EmbeddedSystemClass/patalla_pedidos_domicilo_TIA/Hardware/000_Documentacion/Imagenes_Multimedia/Ensamble2.jpeg

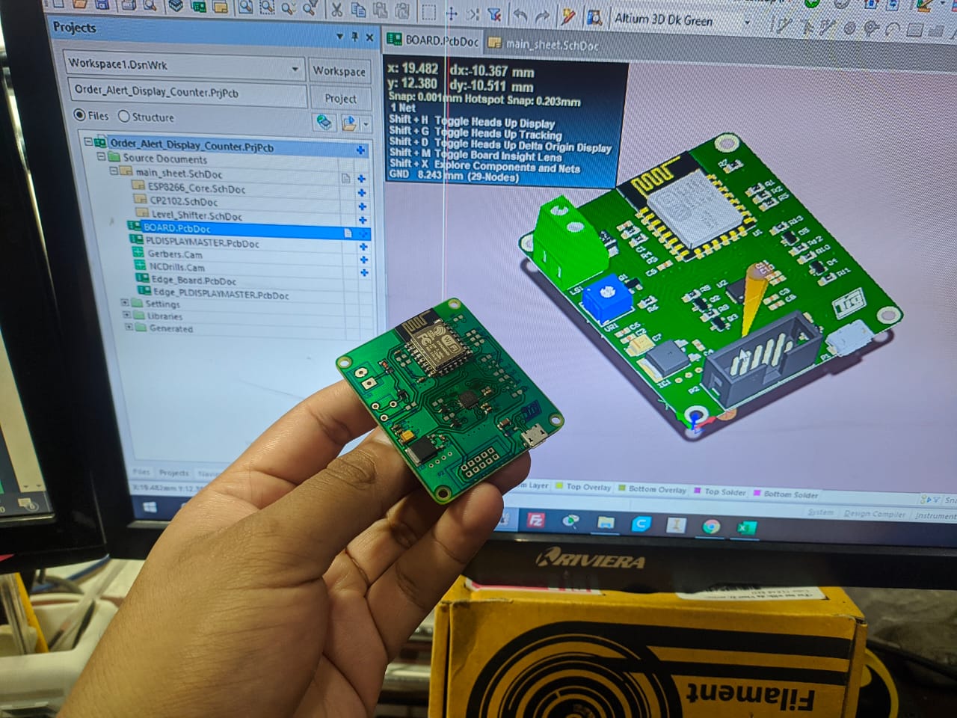
Hardware/000_Documentacion/Imagenes_Multimedia/Ensamble2.jpeg
