EmbeddedSystemClass/patalla_pedidos_domicilo_TIA/README.md

# Alerta_de_Pedidos_Counter
Firmware Arduino de Pantalla de Pedidos, basada en el SOC (Yystem on a chip) ESP8266
