EmbeddedSystemClass/patalla_pedidos_domicilo_TIA/Hardware/000_Documentacion/Imagenes_Multimedia/01_Wifi_Module.png

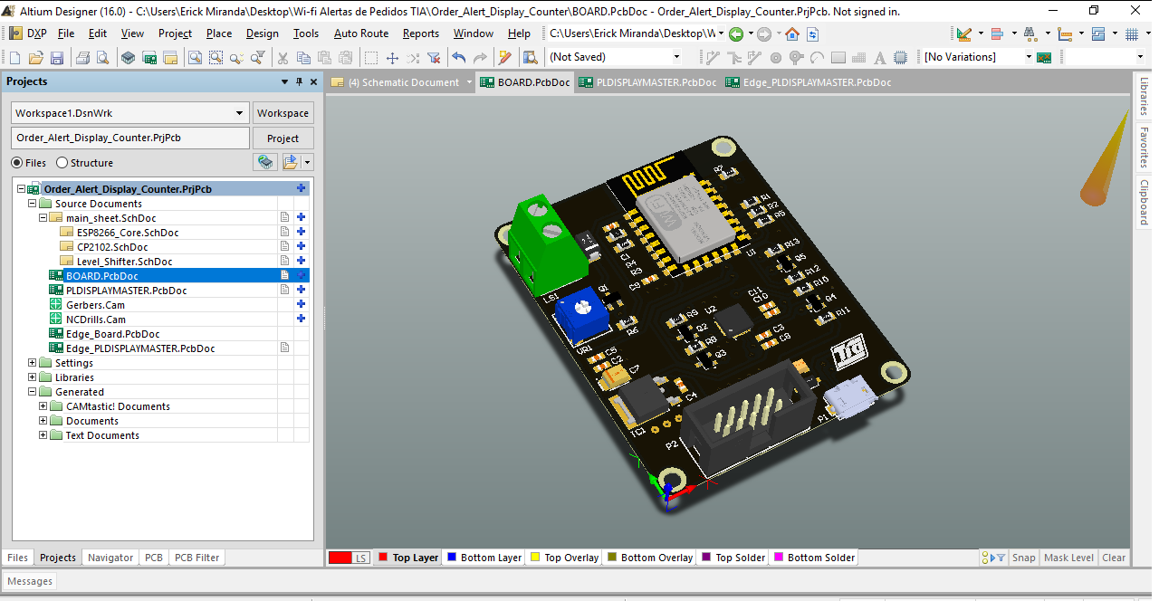
Hardware/000_Documentacion/Imagenes_Multimedia/01_Wifi_Module.png
