EmbeddedSystemClass/patalla_pedidos_domicilo_TIA/Hardware/000_Documentacion/Imagenes_Multimedia/02_DYSPLAY_Module.png

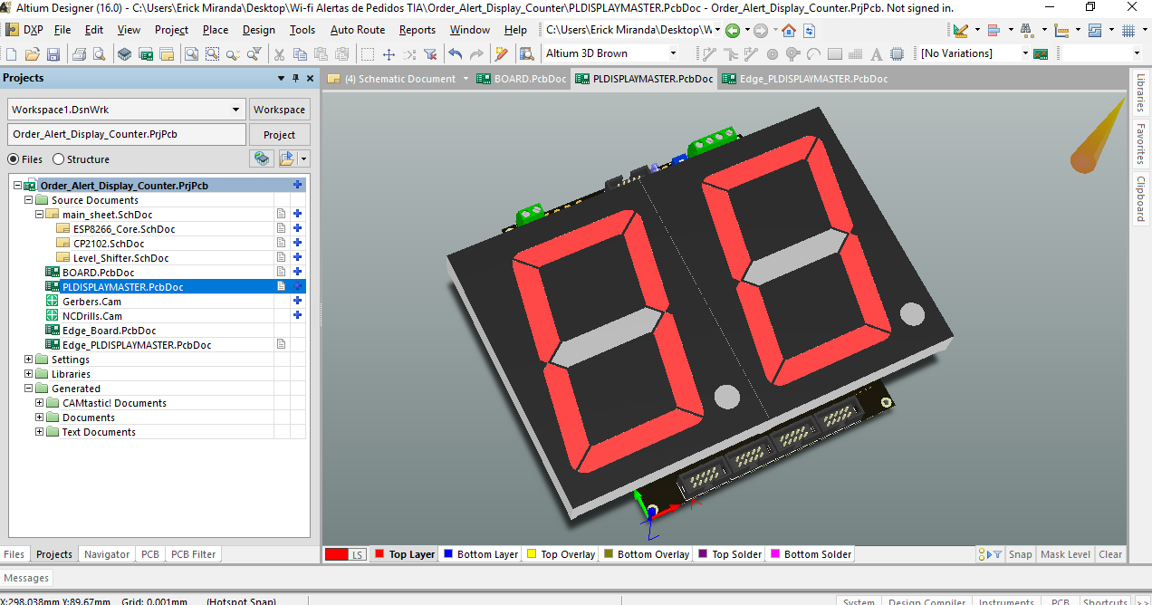
Hardware/000_Documentacion/Imagenes_Multimedia/02_DYSPLAY_Module.png
