EmbeddedSystemClass/patalla_pedidos_domicilo_TIA/Hardware/000_Documentacion/Imagenes_Multimedia/03_Oreder_Alert_Counter_0.png

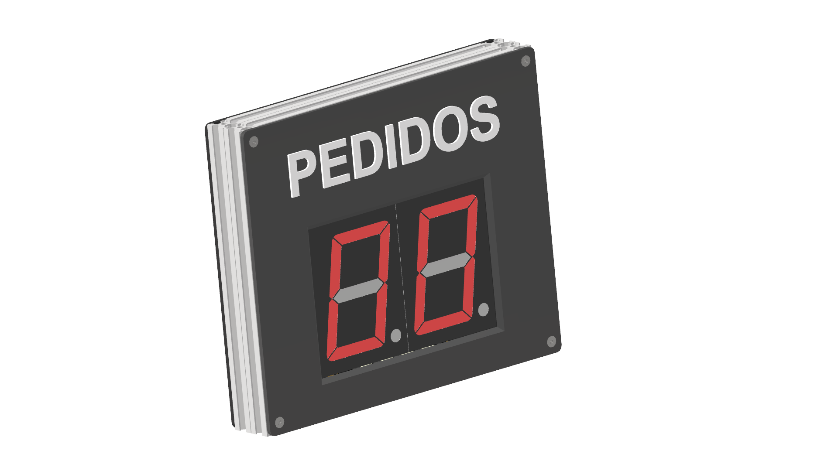
Hardware/000_Documentacion/Imagenes_Multimedia/03_Oreder_Alert_Counter_0.png
