EmbeddedSystemClass/patalla_pedidos_domicilo_TIA/Hardware/000_Documentacion/Imagenes_Multimedia/04_Oreder_Alert_Counter_1.png

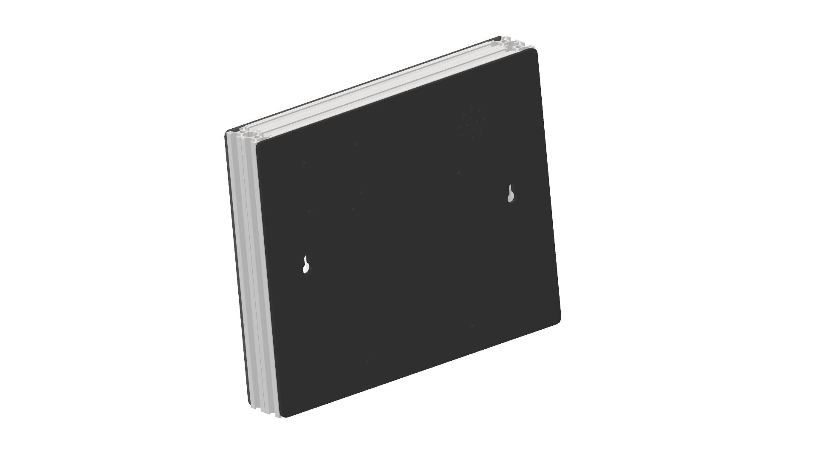
Hardware/000_Documentacion/Imagenes_Multimedia/04_Oreder_Alert_Counter_1.png
