EmbeddedSystemClass/patalla_pedidos_domicilo_TIA/Hardware/000_Documentacion/Imagenes_Multimedia/05_Final Device Price.png

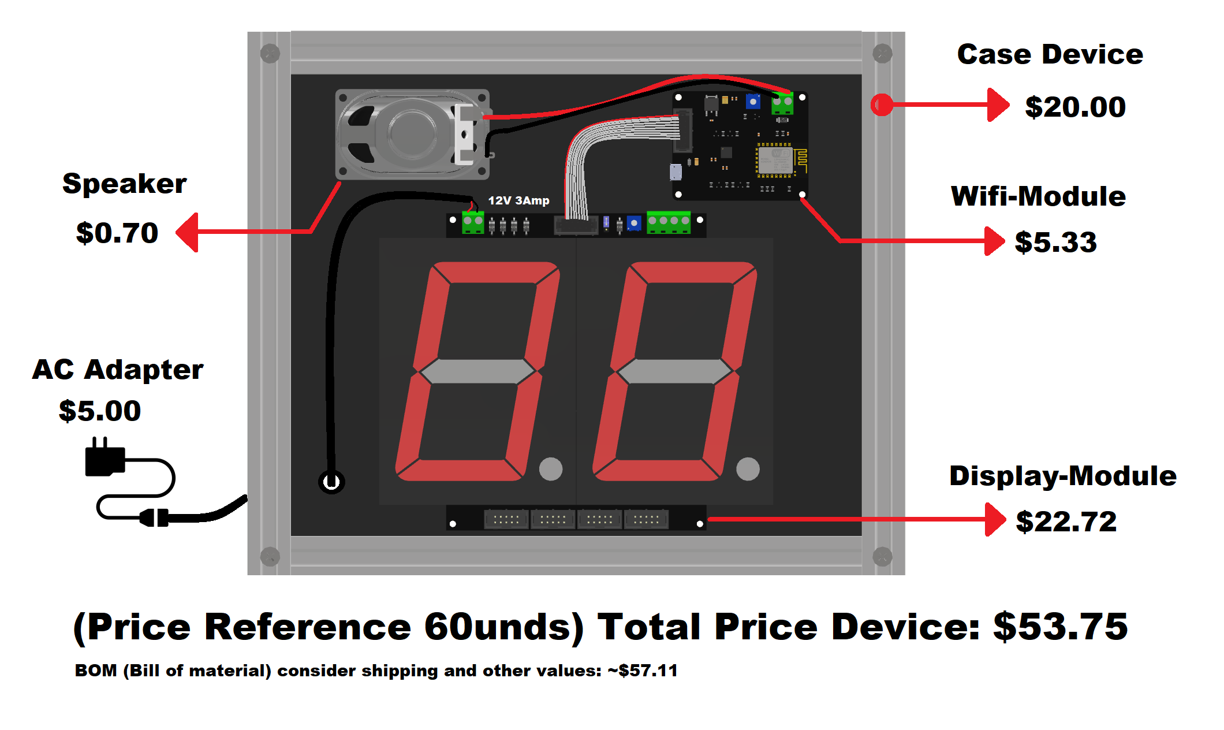
Hardware/000_Documentacion/Imagenes_Multimedia/05_Final Device Price.png
