EmbeddedSystemClass/patalla_pedidos_domicilo_TIA/Hardware/000_Documentacion/Imagenes_Multimedia/Eleccion de Sucursal.jpeg

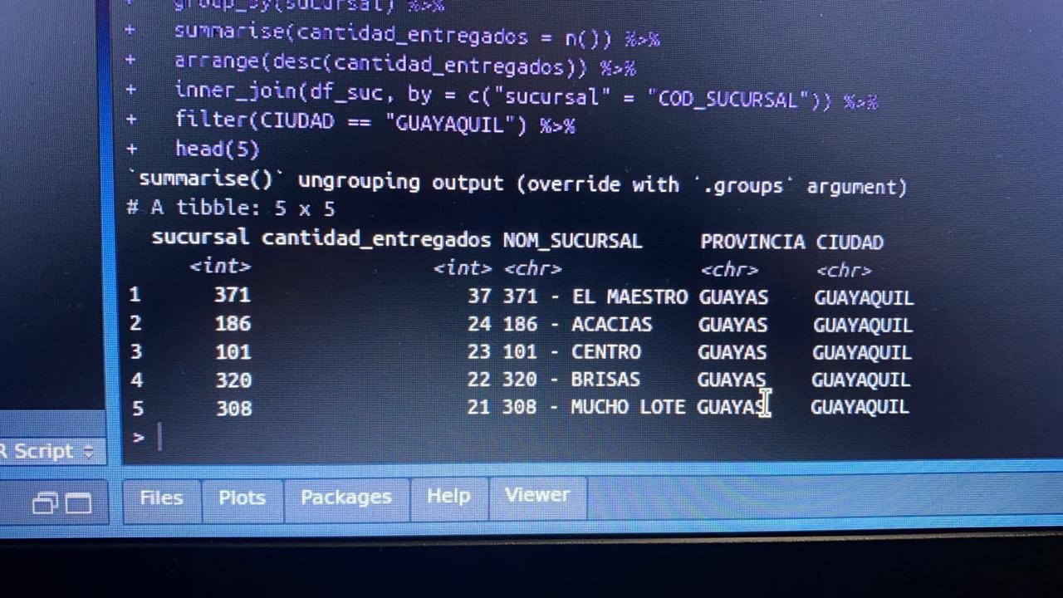
Hardware/000_Documentacion/Imagenes_Multimedia/Eleccion de Sucursal.jpeg
