EmbeddedSystemClass/patalla_pedidos_domicilo_TIA/Hardware/000_Documentacion/Imagenes_Multimedia/Enclosure 2.png

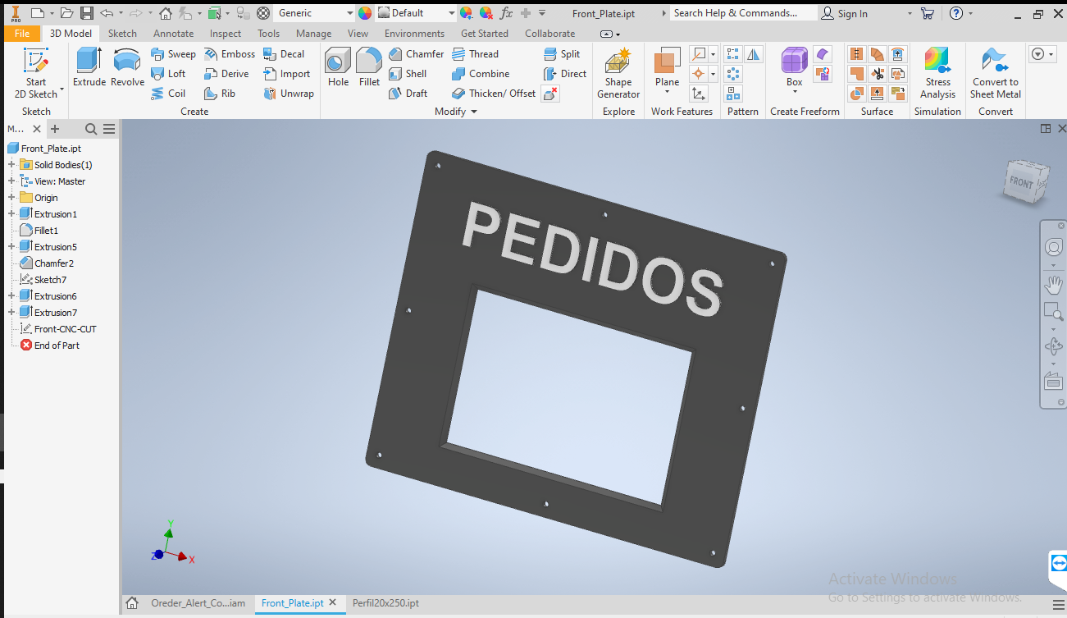
Hardware/000_Documentacion/Imagenes_Multimedia/Enclosure 2.png
