EmbeddedSystemClass/patalla_pedidos_domicilo_TIA/Hardware/000_Documentacion/Imagenes_Multimedia/Factura Adaptador.jpeg

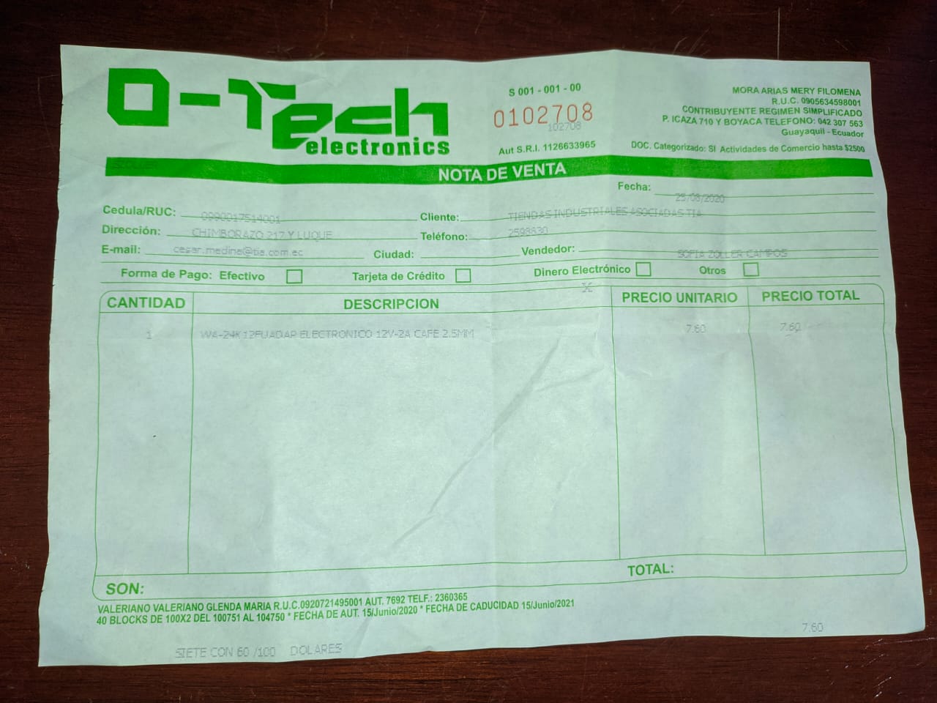
Hardware/000_Documentacion/Imagenes_Multimedia/Factura Adaptador.jpeg
