EmbeddedSystemClass/patalla_pedidos_domicilo_TIA/Hardware/000_Documentacion/Imagenes_Multimedia/Firmware.png

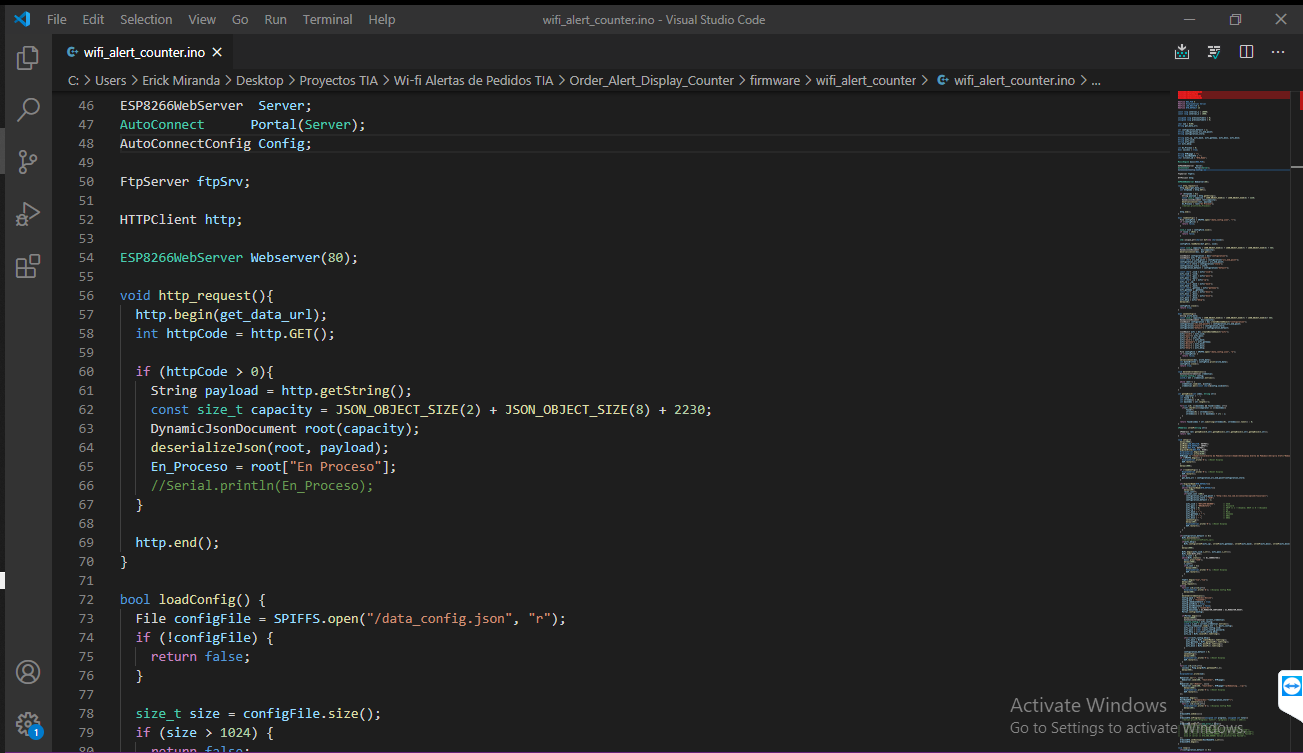
Hardware/000_Documentacion/Imagenes_Multimedia/Firmware.png
