EmbeddedSystemClass/patalla_pedidos_domicilo_TIA/Hardware/000_Documentacion/Imagenes_Multimedia/Panel_wifi_module_Combined_Top.png

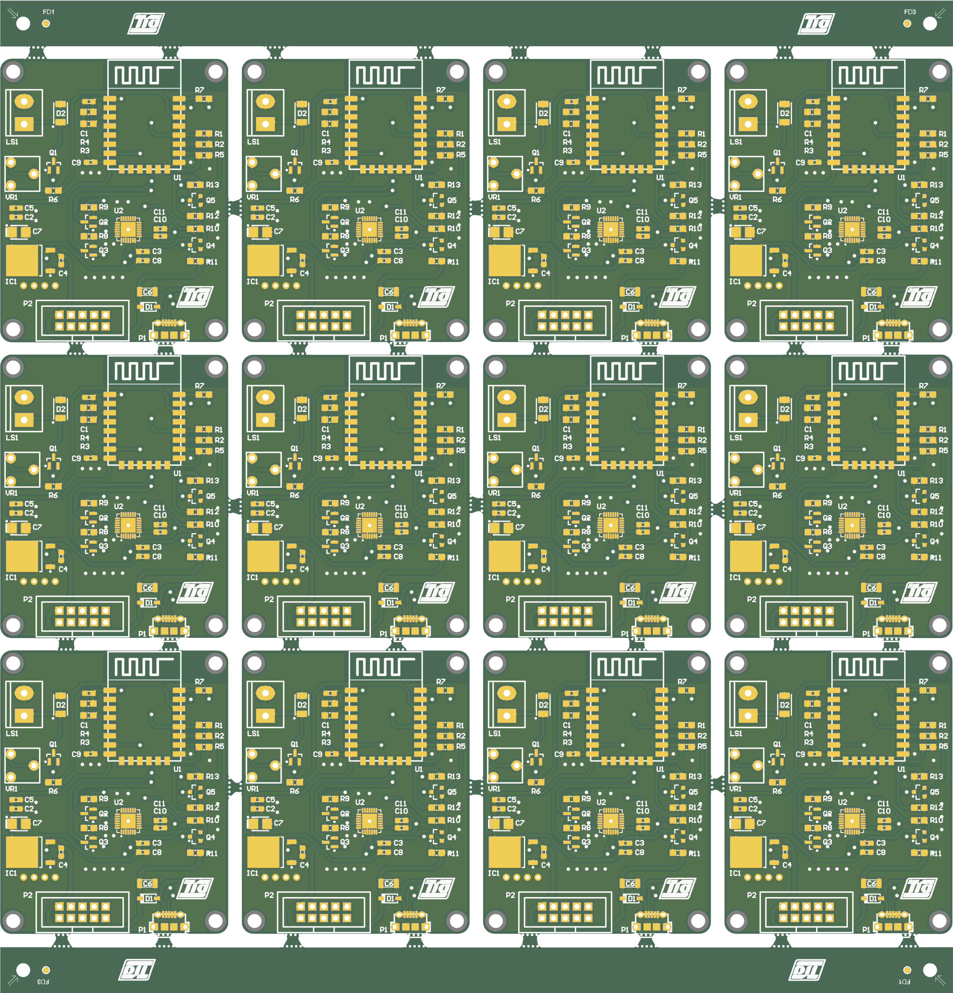
Hardware/000_Documentacion/Imagenes_Multimedia/Panel_wifi_module_Combined_Top.png
