EmbeddedSystemClass/patalla_pedidos_domicilo_TIA/Hardware/000_Documentacion/Imagenes_Multimedia/WhatsApp Image 2020-09-07 at 12.30.22 PM.jpeg

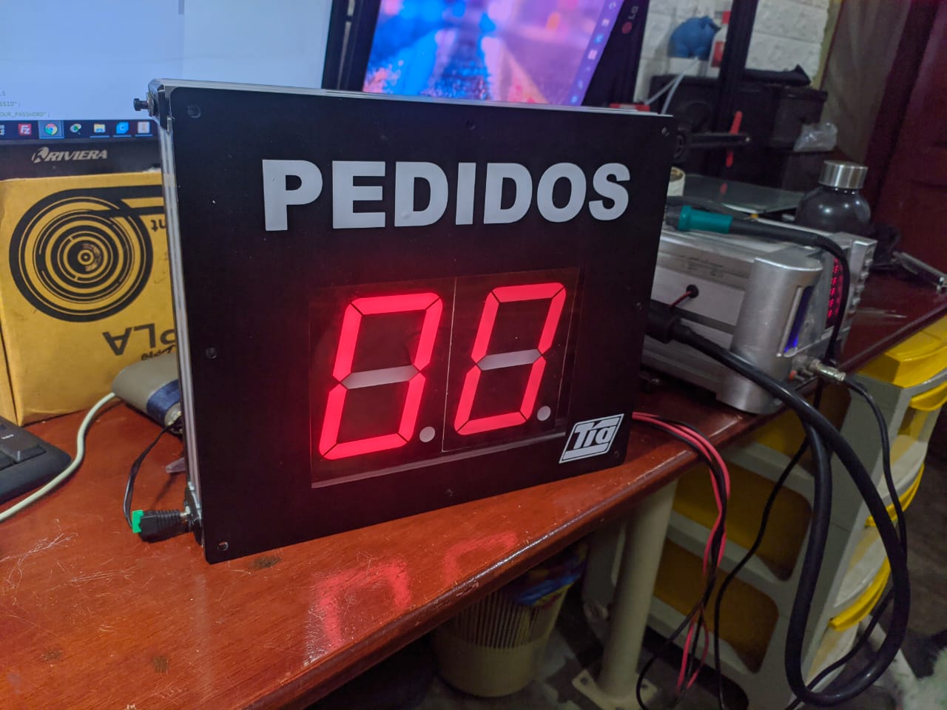
Hardware/000_Documentacion/Imagenes_Multimedia/WhatsApp Image 2020-09-07 at 12.30.22 PM.jpeg
