EmbeddedSystemClass/patalla_pedidos_domicilo_TIA/Hardware/001_Diseño_Electronico/AUTO_PROGRAM.png

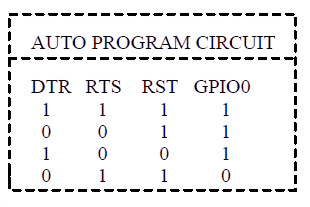
Hardware/001_Diseño_Electronico/AUTO_PROGRAM.png
