EmbeddedSystemClass/patalla_pedidos_domicilo_TIA/Hardware/001_Diseño_Electronico/PEDIDOS.png

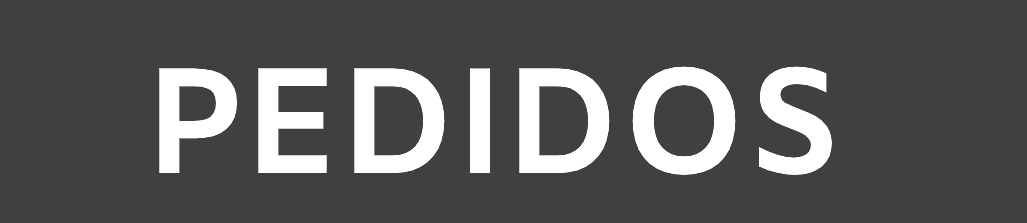
Hardware/001_Diseño_Electronico/PEDIDOS.png
