EmbeddedSystemClass/patalla_pedidos_domicilo_TIA/Hardware/003_Diseño_Mecanico/Inventor_2020/Oreder_Alert_Counter.png

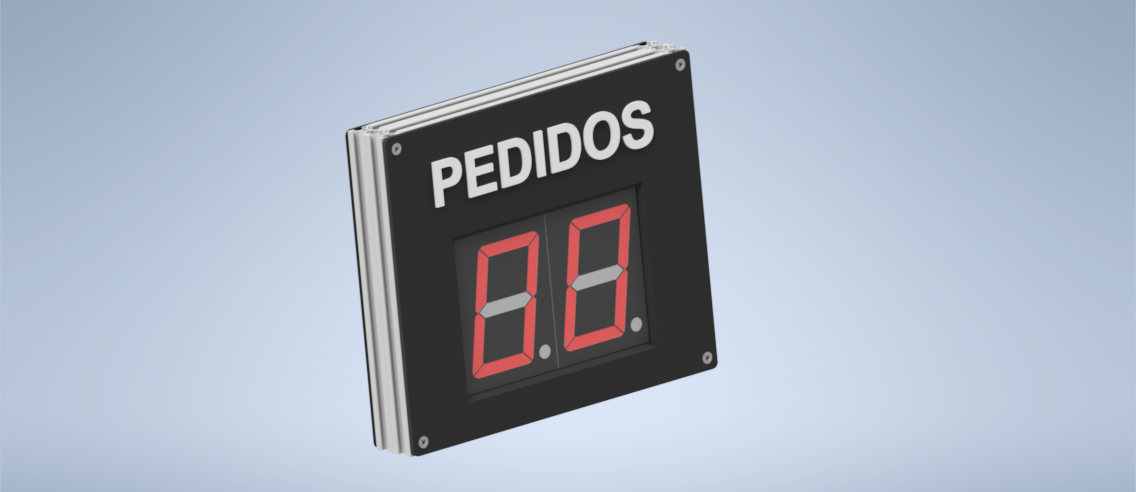
Hardware/003_Diseño_Mecanico/Inventor_2020/Oreder_Alert_Counter.png
