EmbeddedSystemClass/patalla_pedidos_domicilo_TIA/Hardware/000_Documentacion/BOM Device Display Counter Alert.xlsx

Wifi MODULE
Comment | Description | Designator | Footprint | LibRef | Quantity | Price | Subtotal | Link Store
Z-231011010106 | Header, 5-Pin, Dual row | P2 | IDC5X2 | IDC 5X2 | 1 | $0.1600 | $0.1600 | https://lcsc.com/product-detail/IDC-Connectors_nextron-Nextronics-Engineering-Z-231011010106_C221045.html
KF103-5.0-2P | Speaker | LS1 | VERDE 2pin | Speaker | 1 | $0.1200 | $0.1200 | https://lcsc.com/product-detail/New-Quadratic-Unclassified-Data_Cixi-Kefa-Elec-KF103-5-0-2P_C475088.html
3362P-1-502LF | Trimmer Cermet 104 | VR1 | POT LIN VR1 | Trimmer Cermet 104 | 1 | $0.2200 | $0.2200 | https://lcsc.com/product-detail/Precision-Potentiometer_BOURNS_3362P-1-502LF_5KR_C81260.html
C10418 | USB Micro | P1 | USB_MICRO_B_AT | USB Mini | 1 | $0.0600 | $0.0600 | https://lcsc.com/product-detail/USB-Connectors_Jing-Extension-of-the-Electronic-Co-Jing-Extension-of-the-Electronic-Co-MICRO-USB-5S-B-Type-horns-High-temperat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
ESP-12F(ESP8266MOD) | ESP-12E&F Module | U1 | ESP-12E&F Module | ESP-12E&F Module | 1 | $1.9000 | $1.9000 | https://lcsc.com/product-detail/WIFI-Modules_ESP-12F-ESP8266MOD_C82891.html
PCB Fabrication (Fabricacion de Tarjetas) | PCBs Fabrication +16 Parts items JLC PCB Service | Min 5 Panels (12 unds*Panel) | 60 | $171.94 | 1 | $2.8657 | $2.8657 | https://jlcpcb.com/ (https://lcsc.com/product-detail/WIFI-Modules_ESP-12F-ESP8266MOD_C82891.html)
 |  |  |  | PRICE*UND | TOTAL |  | $5.3257
Displays MODULE
Comment | Description | Designator | Footprint | LibRef | Quantity | Price | Subtotal | Link Store
PIC16F886-I/SS | 8-Bit FLASH PIC 20MHz 2V ~ 5.5V SSOP-28_208mil MICROCHIP RoHS | U2 | SSOP-SS28_N | SSOP-SS28_N | 1 | $2.4700 | $2.4700 | https://lcsc.com/product-detail/MICROCHIP_MICROCHIP_PIC16F886-I-SS_PIC16F886-I-SS_C38185.html (https://lcsc.com/product-detail/Precision-Potentiometer_BOURNS_3362P-1-502LF_5KR_C81260.html)
MIC29302WU-TR | Adjustable 26V 1.25V 3A TO-263-5 Low Dropout Regulators(LDO) RoHS | REG1 | MIC29302BU | MIC29302BU | 1 | $1.1600 | $1.1600 | https://lcsc.com/product-detail/Low-Dropout-Regulators-LDO_MICROCHIP_MIC29302WU_MIC29302WU_C11149.html (https://lcsc.com/product-detail/Precision-Potentiometer_BOURNS_3362P-1-502LF_5KR_C81260.html)
RL207 | 1kV 2A 1V @ 2A DO-15 Diodes - General Purpose RoHS | D1, D2, D3, D4, D5 | DIODE-0.3 | DIODE-0.3 | 5 | $0.0259 | $0.1295 | https://lcsc.com/product-detail/Others_GW-RL207_C331654.html (https://lcsc.com/product-detail/Precision-Potentiometer_BOURNS_3362P-1-502LF_5KR_C81260.html)
KF103-5.0-2P | P-5.0mm Screw terminal RoHS | P5 | P-5.0mm | P-5.0mm | 1 | $0.1200 | $0.1200 | https://lcsc.com/product-detail/New-Quadratic-Unclassified-Data_Cixi-Kefa-Elec-KF103-5-0-2P_C475088.html (https://lcsc.com/product-detail/Precision-Potentiometer_BOURNS_3362P-1-502LF_5KR_C81260.html)
Z-231011010106 | Header 10 0.100"(2.54mm) 2 2.54mm 10P IDC Connectors RoHS | XBEE1 | 2.54mm 10P | 2.54mm 10P | 1 | $0.1600 | $0.1600 | https://lcsc.com/product-detail/IDC-Connectors_nextron-Nextronics-Engineering-Z-231011010106_C221045.html (https://lcsc.com/product-detail/Precision-Potentiometer_BOURNS_3362P-1-502LF_5KR_C81260.html)
C44593 | 470uF ±20% 25V 8x16 3000Hrs @ 105℃ Radial,8x16mm Aluminum Electrolytic Capacitors - Leaded RoHS | C1, C10, C25, C32, C34, C35 | Radial,8x16mm | Radial,8x16mm | 6 | $0.0365 | $0.2190 | https://lcsc.com/product-detail/Aluminum-Electrolytic-Capacitors-Leaded_CX-Dongguan-Chengxing-Elec-C44593_C44593.html (https://lcsc.com/product-detail/Precision-Potentiometer_BOURNS_3362P-1-502LF_5KR_C81260.html)
X49SD20MSD2SC | 20MHz ±20ppm 20pF 40 Ohm(Max) HC-49S DIP Crystal Resonators RoHS | Y1 | HC-49S | HC-49S | 1 | $0.0717 | $0.0717 | https://lcsc.com/product-detail/DIP-Crystal-Resonators_Yangxing-Tech-X49SD20MSD2SC_C16370.html
KEM-40011 | 4-inch 1-digit 7-segment display | DS1, DS2 | Display 7Seg 4'' | Display 7Seg 4'' | 2 | $6.3400 | $12.6800 | https://es.aliexpress.com/item/32716179206.html (https://lcsc.com/product-detail/DIP-Crystal-Resonators_Yangxing-Tech-X49SD20MSD2SC_C16370.html)
PCB Fabrication (Fabricacion de Tarjetas) | PCBs Fabrication +16 Parts items JLC PCB Service | Min 5 Panels (12 unds*Panel) | 60 | $342.41 | 1 | $5.7068 | $5.7068 | https://jlcpcb.com/ (https://lcsc.com/product-detail/WIFI-Modules_ESP-12F-ESP8266MOD_C82891.html)
 |  |  |  | PRICE*UND | TOTAL |  | $22.7170
OTHERS COMPONENTS
Comment | Description | Designator | Footprint | LibRef | Quantity | Price | Subtotal | Link Store
FS4020NS0820-H5.8 | SPK | Speaker | Speaker |  | 1 | $0.6900 | $0.6900 | https://lcsc.com/product-detail/Speakers_FUET-FS4020NS0820-H5-8_C482324.html (https://lcsc.com/product-detail/WIFI-Modules_ESP-12F-ESP8266MOD_C82891.html)
Power Supply | 12v 3amp | 12v 3a | Power Suppy |  | 1 | $5.0000 | $5.0000 | https://articulo.mercadolibre.com.ec/MEC-425803980-fuente-energia-cargador-12v-3a-_JM
Flat Wire | Flat wire 10Pin 15cm | Wire | Speaker |  | 1 | $0.7500 | $0.7500 | https://articulo.mercadolibre.com.ec/MEC-425828157-cable-plano-flat-cable-5-metros-_JM?quantity=1 (https://lcsc.com/product-detail/WIFI-Modules_ESP-12F-ESP8266MOD_C82891.html)
C8373 | IDCconnector 10 0.100"(2.54mm) 2 2X5P IDC Connectors RoHS | IDC | IDC2X5 |  | 2 | $0.0645 | $0.1290 | https://lcsc.com/product-detail/IDC-Connectors_BOOMELE-Boom-Precision-Elec-C8373_C8373.html (https://lcsc.com/product-detail/WIFI-Modules_ESP-12F-ESP8266MOD_C82891.html)
Enclosure Case | Box Device | Box | Box |  | 1 | $20.0000 | $20.0000 | https://www.shapeways.com/
~Shipping | DHL International Express |  | 60 | $150.00 | 1 | $2.5000 | $2.5000 | https://jlcpcb.com/ (https://lcsc.com/product-detail/WIFI-Modules_ESP-12F-ESP8266MOD_C82891.html)
 |  |  |  | PRICE*UND | TOTAL |  | $29.0690
 |  |  |  | TOTAL DEVICE |  |  | $57.1116
