EmbeddedSystemClass/patalla_pedidos_domicilo_TIA/Hardware/000_Documentacion/Imagenes_Multimedia/06_Counter Order Alert.png

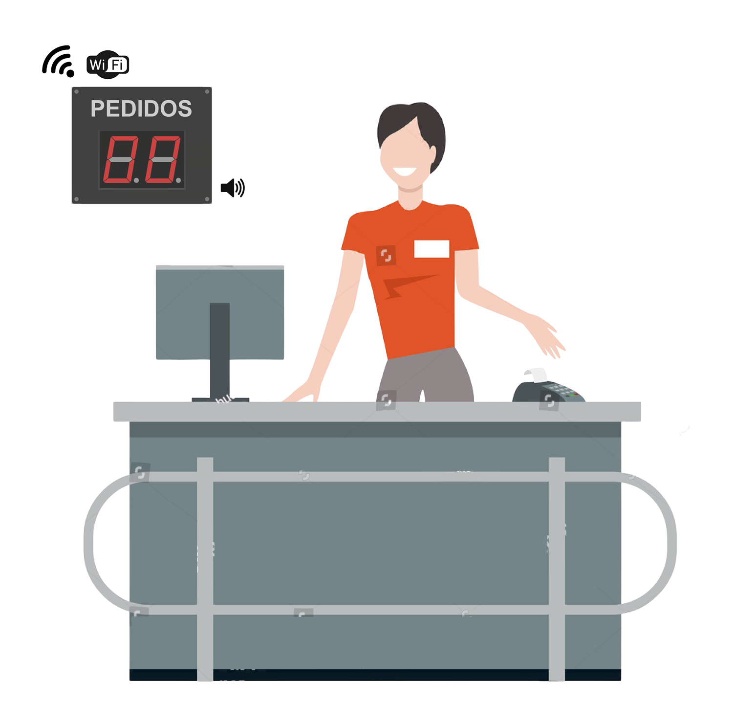
Hardware/000_Documentacion/Imagenes_Multimedia/06_Counter Order Alert.png
