EmbeddedSystemClass/patalla_pedidos_domicilo_TIA/Hardware/003_Diseño_Mecanico/Inventor_2020/28mm 8Ohm 1W Full Range Audio Speaker.STEP

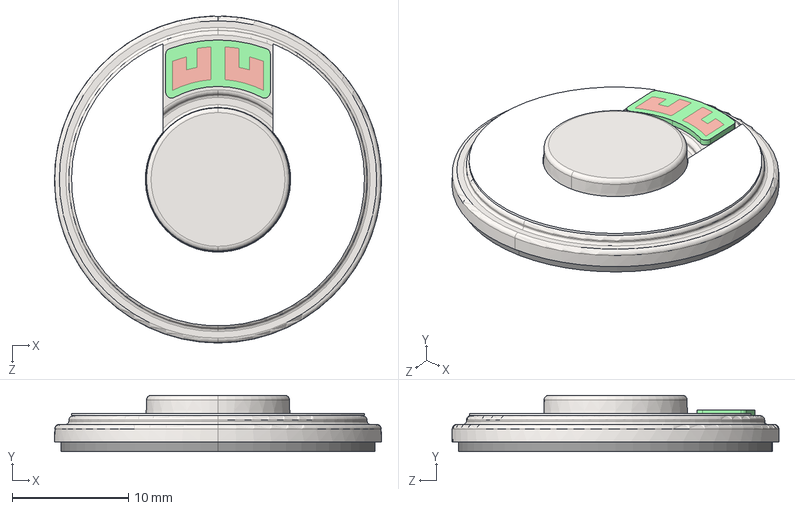
[picture p25: CAD file, 2020-12-29]
Hardware/003_Diseño_Mecanico/Inventor_2020/28mm 8Ohm 1W Full Range Audio Speaker.STEP
28.1 x 4.85 x 28.1 mm
