EmbeddedSystemClass/patalla_pedidos_domicilo_TIA/Hardware/001_Diseño_Electronico/Lib_Altium/CP2102-GM_Lib/User Library-PQFN50P500X500X100_HS-29N.STEP

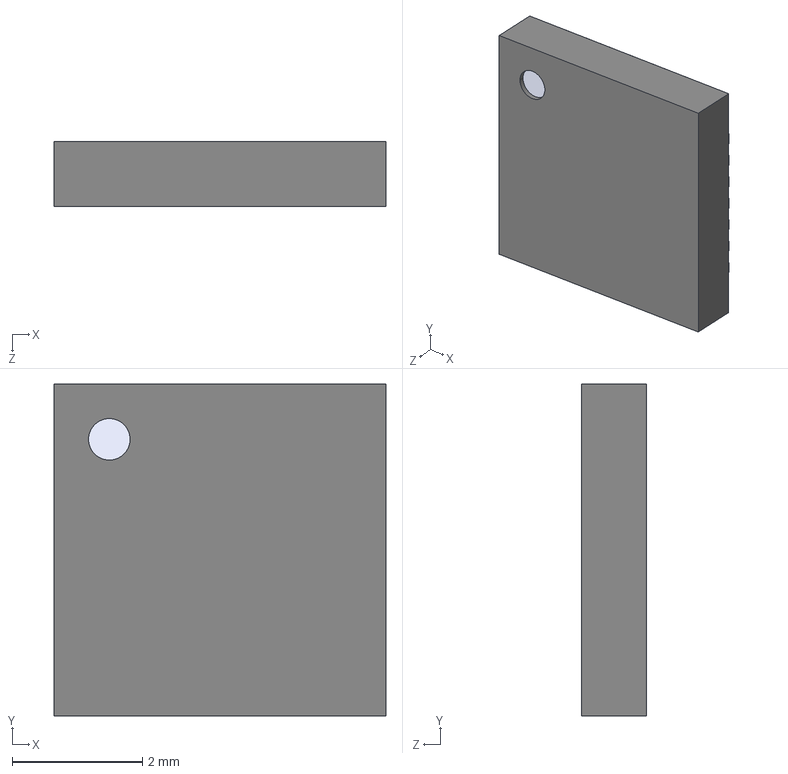
[picture p26: CAD file, 2020-12-29]
Hardware/001_Diseño_Electronico/Lib_Altium/CP2102-GM_Lib/User Library-PQFN50P500X500X100_HS-29N.STEP
5.10 x 5.10 x 1.00 mm
Open_CASCADE_STEP_translator_6.8_1.1
Open_CASCADE_STEP_translator_6.8_1.2.1
Thermal_Shape
Pin_Shape x 28
