EmbeddedSystemClass/patalla_pedidos_domicilo_TIA/Hardware/003_Diseño_Mecanico/Inventor_2020/hexagonal_spacer_FF_M3_H20_HEX5_FTD9.step

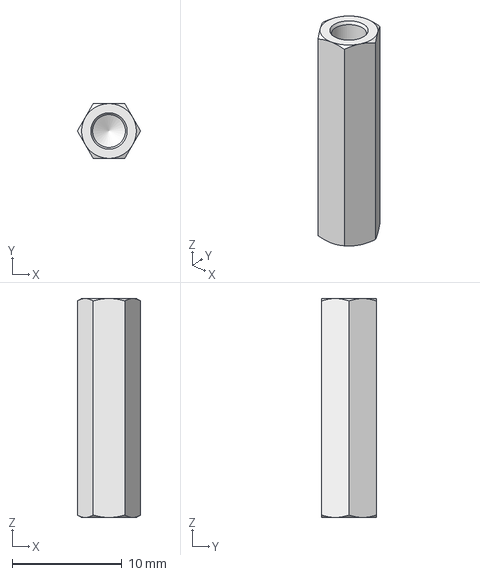
[picture p27: CAD file, 2020-12-29]
Hardware/003_Diseño_Mecanico/Inventor_2020/hexagonal_spacer_FF_M3_H20_HEX5_FTD9.step
5.78 x 5.01 x 20.0 mm
