EmbeddedSystemClass/patalla_pedidos_domicilo_TIA/Hardware/004_Fabricacion_Mecanica/Case_Pedidos_Counter/Separadores_PCB17mm.stl

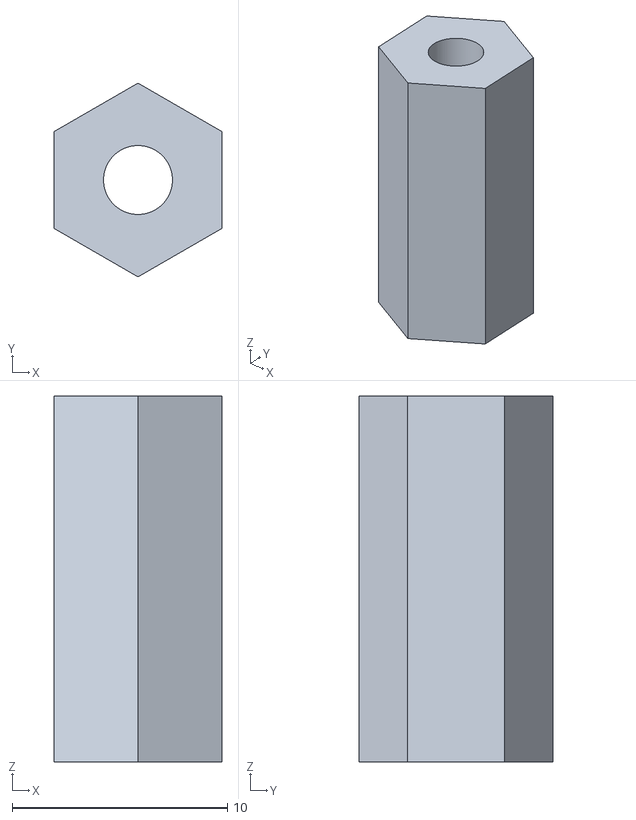
[picture p28: CAD file, 2020-12-29]
Hardware/004_Fabricacion_Mecanica/Case_Pedidos_Counter/Separadores_PCB17mm.stl
7.79 x 9.00 x 17.0
