EmbeddedSystemClass/patalla_pedidos_domicilo_TIA/Hardware/003_Diseño_Mecanico/Inventor_2020/Visaton SC 4.7 ND Speaker.stp

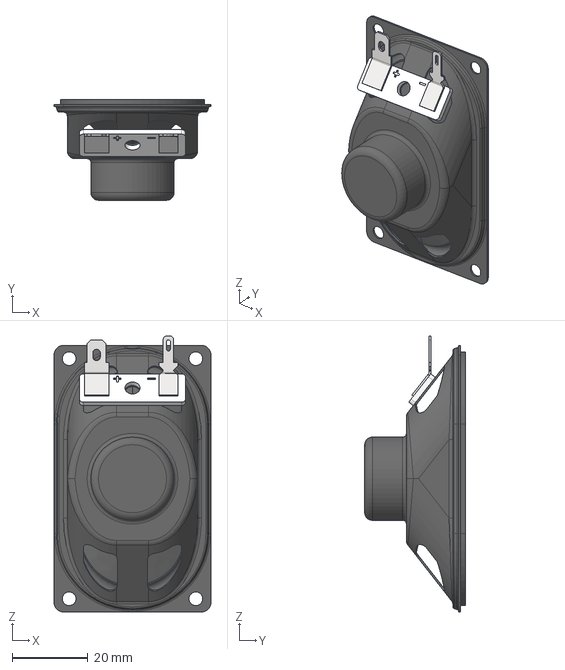
[picture p29: CAD file, 2020-12-29]
Hardware/003_Diseño_Mecanico/Inventor_2020/Visaton SC 4.7 ND Speaker.stp
41.5 x 26.6 x 73.0 mm
