EmbeddedSystemClass/patalla_pedidos_domicilo_TIA/Hardware/004_Fabricacion_Mecanica/Case_Pedidos_Counter/Separadores_PCB10mm.stl

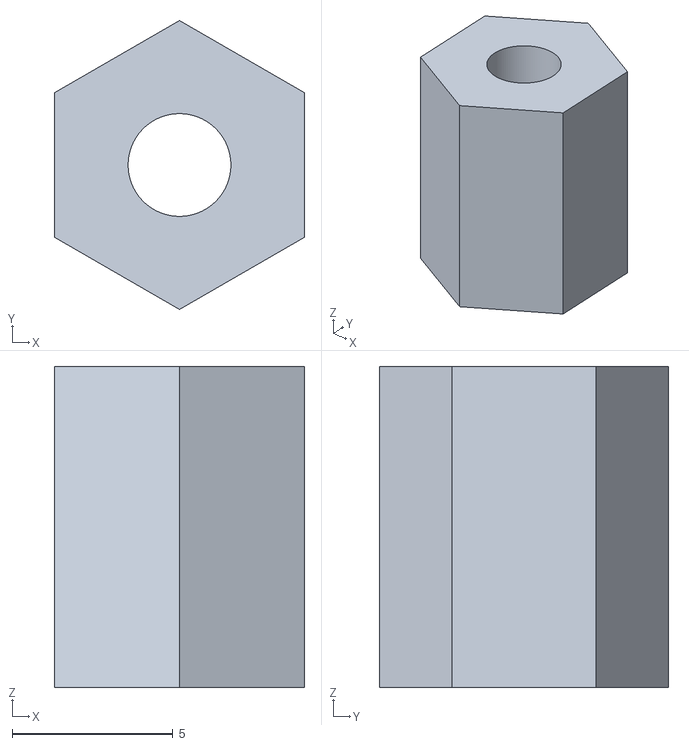
[picture p30: CAD file, 2020-12-29]
Hardware/004_Fabricacion_Mecanica/Case_Pedidos_Counter/Separadores_PCB10mm.stl
7.79 x 9.00 x 10.0
