EmbeddedSystemClass/patalla_pedidos_domicilo_TIA/Hardware/003_Diseño_Mecanico/Inventor_2020/User Library-KLS1-204C-10-B.STEP

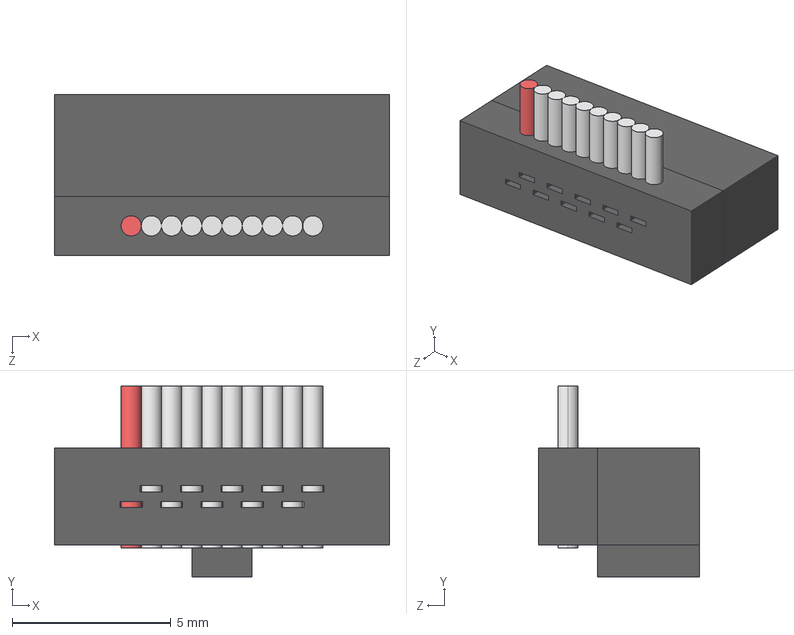
[picture p31: CAD file, 2020-12-29]
Hardware/003_Diseño_Mecanico/Inventor_2020/User Library-KLS1-204C-10-B.STEP
10.5 x 6.00 x 5.05 mm
