EmbeddedSystemClass/patalla_pedidos_domicilo_TIA/Hardware/003_Diseño_Mecanico/Inventor_2020/73k0102_1658621-1.stp

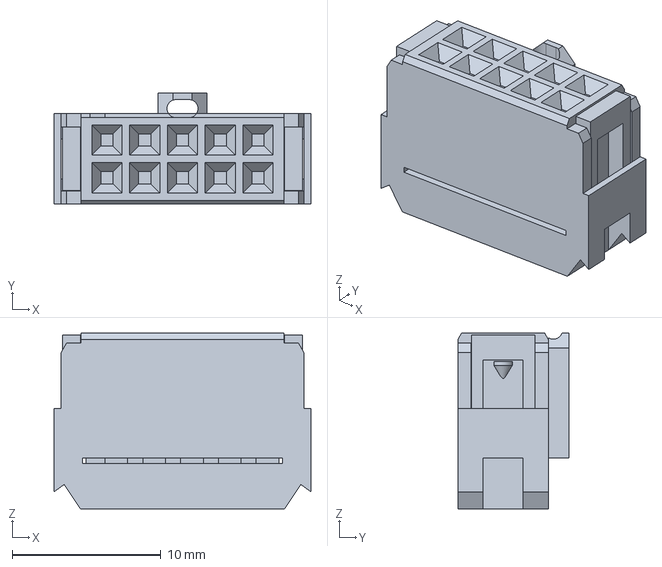
[picture p32: CAD file, 2020-12-29]
Hardware/003_Diseño_Mecanico/Inventor_2020/73k0102_1658621-1.stp
17.3 x 7.49 x 11.8 mm
