EmbeddedSystemClass/patalla_pedidos_domicilo_TIA/Hardware/003_Diseño_Mecanico/Inventor_2020/hexagonal_spacer_FF_M3_H10_HEX5_pass_through.step

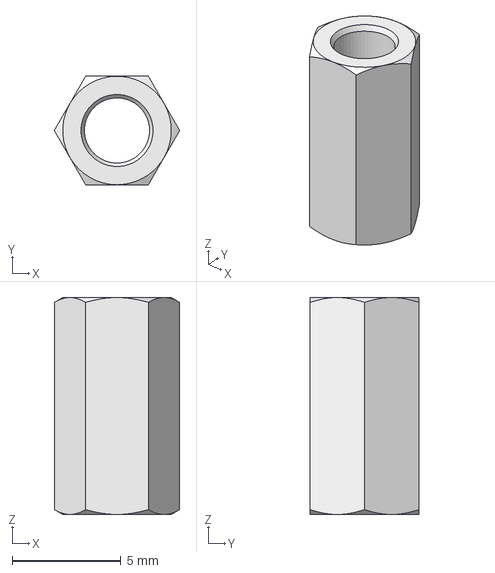
[picture p34: CAD file, 2020-12-29]
Hardware/003_Diseño_Mecanico/Inventor_2020/hexagonal_spacer_FF_M3_H10_HEX5_pass_through.step
5.78 x 5.01 x 10.0 mm
