EmbeddedSystemClass/patalla_pedidos_domicilo_TIA/(list of files, cad)

Other CAD files:
Hardware/004_Fabricacion_Mecanica/Case_Pedidos_Counter/Pedidos_CNC-CUT/Back.dwg
Hardware/004_Fabricacion_Mecanica/Case_Pedidos_Counter/Pedidos_CNC-CUT/Front.dwg
Hardware/003_Diseño_Mecanico/Inventor_2020/28mm 8Ohm 1W Full Range Audio Speaker.ipt
Hardware/003_Diseño_Mecanico/Inventor_2020/73k0102_1658621-1.ipt
Hardware/003_Diseño_Mecanico/Inventor_2020/Back_Plate.ipt
Hardware/003_Diseño_Mecanico/Inventor_2020/Display2Dig/931411456.iam
Hardware/003_Diseño_Mecanico/Inventor_2020/Display2Dig/931418936.iam
Hardware/003_Diseño_Mecanico/Inventor_2020/Display2Dig/931419072.iam
Hardware/003_Diseño_Mecanico/Inventor_2020/Display2Dig/931419208.iam
Hardware/003_Diseño_Mecanico/Inventor_2020/Display2Dig/931419344.iam
Hardware/003_Diseño_Mecanico/Inventor_2020/Display2Dig/931419480.iam
Hardware/003_Diseño_Mecanico/Inventor_2020/Display2Dig/931419616.iam
Hardware/003_Diseño_Mecanico/Inventor_2020/Display2Dig/Board.ipt
Hardware/003_Diseño_Mecanico/Inventor_2020/Display2Dig/C11.iam
Hardware/003_Diseño_Mecanico/Inventor_2020/Display2Dig/C12.iam
Hardware/003_Diseño_Mecanico/Inventor_2020/Display2Dig/C13.iam
Hardware/003_Diseño_Mecanico/Inventor_2020/Display2Dig/C14.iam
Hardware/003_Diseño_Mecanico/Inventor_2020/Display2Dig/C15.iam
Hardware/003_Diseño_Mecanico/Inventor_2020/Display2Dig/C16.iam
Hardware/003_Diseño_Mecanico/Inventor_2020/Display2Dig/C17.iam
Hardware/003_Diseño_Mecanico/Inventor_2020/Display2Dig/C18.iam
Hardware/003_Diseño_Mecanico/Inventor_2020/Display2Dig/C19.iam
Hardware/003_Diseño_Mecanico/Inventor_2020/Display2Dig/C2.iam
Hardware/003_Diseño_Mecanico/Inventor_2020/Display2Dig/C20.iam
Hardware/003_Diseño_Mecanico/Inventor_2020/Display2Dig/C21.iam
Hardware/003_Diseño_Mecanico/Inventor_2020/Display2Dig/C22.iam
Hardware/003_Diseño_Mecanico/Inventor_2020/Display2Dig/C23.iam
Hardware/003_Diseño_Mecanico/Inventor_2020/Display2Dig/C24.iam
Hardware/003_Diseño_Mecanico/Inventor_2020/Display2Dig/C26.iam
Hardware/003_Diseño_Mecanico/Inventor_2020/Display2Dig/C27.iam
Hardware/003_Diseño_Mecanico/Inventor_2020/Display2Dig/C28.iam
Hardware/003_Diseño_Mecanico/Inventor_2020/Display2Dig/C29.iam
Hardware/003_Diseño_Mecanico/Inventor_2020/Display2Dig/C3.iam
Hardware/003_Diseño_Mecanico/Inventor_2020/Display2Dig/C30.iam
Hardware/003_Diseño_Mecanico/Inventor_2020/Display2Dig/C31.iam
Hardware/003_Diseño_Mecanico/Inventor_2020/Display2Dig/C33.iam
Hardware/003_Diseño_Mecanico/Inventor_2020/Display2Dig/C4.iam
Hardware/003_Diseño_Mecanico/Inventor_2020/Display2Dig/C5.iam
Hardware/003_Diseño_Mecanico/Inventor_2020/Display2Dig/C6.iam
Hardware/003_Diseño_Mecanico/Inventor_2020/Display2Dig/C7.iam
Hardware/003_Diseño_Mecanico/Inventor_2020/Display2Dig/C8.iam
Hardware/003_Diseño_Mecanico/Inventor_2020/Display2Dig/C9.iam
Hardware/003_Diseño_Mecanico/Inventor_2020/Display2Dig/Display7_Segments_4inchs0.ipt
Hardware/003_Diseño_Mecanico/Inventor_2020/Display2Dig/Display7_Segments_4inchs1.ipt
Hardware/003_Diseño_Mecanico/Inventor_2020/Display2Dig/Extruded.ipt
Hardware/003_Diseño_Mecanico/Inventor_2020/Display2Dig/Extruded_1.ipt
Hardware/003_Diseño_Mecanico/Inventor_2020/Display2Dig/Extruded_2.ipt
Hardware/003_Diseño_Mecanico/Inventor_2020/Display2Dig/Extruded_3.ipt
Hardware/003_Diseño_Mecanico/Inventor_2020/Display2Dig/Extruded_4.ipt
Hardware/003_Diseño_Mecanico/Inventor_2020/Display2Dig/Extruded_5.ipt
Hardware/003_Diseño_Mecanico/Inventor_2020/Display2Dig/Extruded_6.ipt
Hardware/003_Diseño_Mecanico/Inventor_2020/Display2Dig/Free-Models.iam
Hardware/003_Diseño_Mecanico/Inventor_2020/Display2Dig/PLDISPLAYMASTER.iam
Hardware/003_Diseño_Mecanico/Inventor_2020/Display2Dig/Q1.iam
Hardware/003_Diseño_Mecanico/Inventor_2020/Display2Dig/Q2.iam
Hardware/003_Diseño_Mecanico/Inventor_2020/Display2Dig/Q3.iam
Hardware/003_Diseño_Mecanico/Inventor_2020/Display2Dig/Q4.iam
Hardware/003_Diseño_Mecanico/Inventor_2020/Display2Dig/Q5.iam
Hardware/003_Diseño_Mecanico/Inventor_2020/Display2Dig/Q6.iam
Hardware/003_Diseño_Mecanico/Inventor_2020/Display2Dig/R1.iam
Hardware/003_Diseño_Mecanico/Inventor_2020/Display2Dig/R10.iam
Hardware/003_Diseño_Mecanico/Inventor_2020/Display2Dig/R11.iam
Hardware/003_Diseño_Mecanico/Inventor_2020/Display2Dig/R12.iam
Hardware/003_Diseño_Mecanico/Inventor_2020/Display2Dig/R13.iam
Hardware/003_Diseño_Mecanico/Inventor_2020/Display2Dig/R14.iam
Hardware/003_Diseño_Mecanico/Inventor_2020/Display2Dig/R15.iam
Hardware/003_Diseño_Mecanico/Inventor_2020/Display2Dig/R16.iam
Hardware/003_Diseño_Mecanico/Inventor_2020/Display2Dig/R17.iam
Hardware/003_Diseño_Mecanico/Inventor_2020/Display2Dig/R18.iam
Hardware/003_Diseño_Mecanico/Inventor_2020/Display2Dig/R19.iam
Hardware/003_Diseño_Mecanico/Inventor_2020/Display2Dig/R2.iam
Hardware/003_Diseño_Mecanico/Inventor_2020/Display2Dig/R20.iam
Hardware/003_Diseño_Mecanico/Inventor_2020/Display2Dig/R21.iam
Hardware/003_Diseño_Mecanico/Inventor_2020/Display2Dig/R22.iam
Hardware/003_Diseño_Mecanico/Inventor_2020/Display2Dig/R23.iam
Hardware/003_Diseño_Mecanico/Inventor_2020/Display2Dig/R24.iam
Hardware/003_Diseño_Mecanico/Inventor_2020/Display2Dig/R25.iam
Hardware/003_Diseño_Mecanico/Inventor_2020/Display2Dig/R26.iam
Hardware/003_Diseño_Mecanico/Inventor_2020/Display2Dig/R27.iam
Hardware/003_Diseño_Mecanico/Inventor_2020/Display2Dig/R28.iam
Hardware/003_Diseño_Mecanico/Inventor_2020/Display2Dig/R29.iam
Hardware/003_Diseño_Mecanico/Inventor_2020/Display2Dig/R3.iam
Hardware/003_Diseño_Mecanico/Inventor_2020/Display2Dig/R30.iam
Hardware/003_Diseño_Mecanico/Inventor_2020/Display2Dig/R31.iam
Hardware/003_Diseño_Mecanico/Inventor_2020/Display2Dig/R32.iam
Hardware/003_Diseño_Mecanico/Inventor_2020/Display2Dig/R33.iam
Hardware/003_Diseño_Mecanico/Inventor_2020/Display2Dig/R34.iam
Hardware/003_Diseño_Mecanico/Inventor_2020/Display2Dig/R35.iam
Hardware/003_Diseño_Mecanico/Inventor_2020/Display2Dig/R36.iam
Hardware/003_Diseño_Mecanico/Inventor_2020/Display2Dig/R37.iam
Hardware/003_Diseño_Mecanico/Inventor_2020/Display2Dig/R38.iam
Hardware/003_Diseño_Mecanico/Inventor_2020/Display2Dig/R39.iam
Hardware/003_Diseño_Mecanico/Inventor_2020/Display2Dig/R4.iam
Hardware/003_Diseño_Mecanico/Inventor_2020/Display2Dig/R40.iam
Hardware/003_Diseño_Mecanico/Inventor_2020/Display2Dig/R41.iam
Hardware/003_Diseño_Mecanico/Inventor_2020/Display2Dig/R42.iam
Hardware/003_Diseño_Mecanico/Inventor_2020/Display2Dig/R43.iam
Hardware/003_Diseño_Mecanico/Inventor_2020/Display2Dig/R44.iam
Hardware/003_Diseño_Mecanico/Inventor_2020/Display2Dig/R45.iam
Hardware/003_Diseño_Mecanico/Inventor_2020/Display2Dig/R46.iam
Hardware/003_Diseño_Mecanico/Inventor_2020/Display2Dig/R47.iam
Hardware/003_Diseño_Mecanico/Inventor_2020/Display2Dig/R48.iam
Hardware/003_Diseño_Mecanico/Inventor_2020/Display2Dig/R49.iam
Hardware/003_Diseño_Mecanico/Inventor_2020/Display2Dig/R5.iam
Hardware/003_Diseño_Mecanico/Inventor_2020/Display2Dig/R50.iam
Hardware/003_Diseño_Mecanico/Inventor_2020/Display2Dig/R51.iam
Hardware/003_Diseño_Mecanico/Inventor_2020/Display2Dig/R52.iam
Hardware/003_Diseño_Mecanico/Inventor_2020/Display2Dig/R53.iam
Hardware/003_Diseño_Mecanico/Inventor_2020/Display2Dig/R6.iam
Hardware/003_Diseño_Mecanico/Inventor_2020/Display2Dig/R7.iam
Hardware/003_Diseño_Mecanico/Inventor_2020/Display2Dig/R8.iam
Hardware/003_Diseño_Mecanico/Inventor_2020/Display2Dig/R9.iam
Hardware/003_Diseño_Mecanico/Inventor_2020/Display2Dig/RES3216-1206.ipt
Hardware/003_Diseño_Mecanico/Inventor_2020/Display2Dig/SW3dPS-0603_SMD_Capacitor.ipt
Hardware/003_Diseño_Mecanico/Inventor_2020/Display2Dig/SW3dPS-SOIC18-300.ipt
Hardware/003_Diseño_Mecanico/Inventor_2020/Display2Dig/U1.iam
Hardware/003_Diseño_Mecanico/Inventor_2020/Display2Dig/U2.iam
Hardware/003_Diseño_Mecanico/Inventor_2020/Display2Dig/U3.iam
Hardware/003_Diseño_Mecanico/Inventor_2020/Display2Dig/U4.iam
Hardware/003_Diseño_Mecanico/Inventor_2020/Display2Dig/U5.iam
Hardware/003_Diseño_Mecanico/Inventor_2020/Display2Dig/User_Library-Bourns_3362F.ipt
Hardware/003_Diseño_Mecanico/Inventor_2020/Display2Dig/User_Library-Diode_1N4004_x7mm_(pcb).ipt
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
