EmbeddedSystemClass/patalla_pedidos_domicilo_TIA/Hardware/004_Fabricacion_Mecanica/Case_Pedidos_Counter/Case_Pedidos Counter.pdf

No.Parte o Identificacion | Imagen | Descrpcion | Cantidad | $ Precio/Und | Subtotal
1.5metros Perfil 20X40 Tipo V Slot | | Los perfiles de aluminio con riel tipo V permiten un ensamblaje sumamente fácil y rápido | 1 | $24.00 | $24.00
Tuerca T simple | | Modulo Semaforo+Alarma 12V | 25 | $0.10 | $2.50
TOTAL | $26.50
