EmbeddedSystemClass/patalla_pedidos_domicilo_TIA/Hardware/000_Documentacion/Imagenes_Multimedia/07_PCB(Printed-Circuit-Board)+SMT(Surface-Mount Technology).png

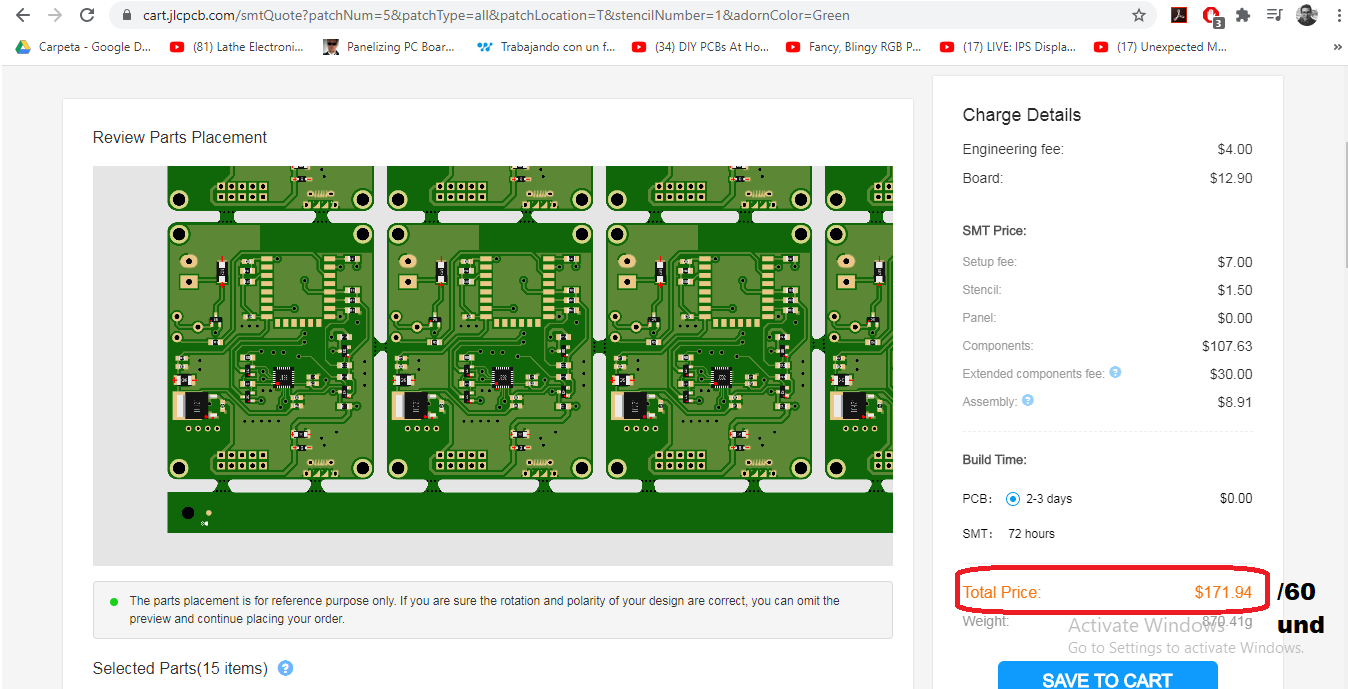
Hardware/000_Documentacion/Imagenes_Multimedia/07_PCB(Printed-Circuit-Board)+SMT(Surface-Mount Technology).png
