EmbeddedSystemClass/patalla_pedidos_domicilo_TIA/Hardware/000_Documentacion/Imagenes_Multimedia/08_PCB(Printed-Circuit-Board)+SMT(Surface-Mount Technology)DYSPLAYS.png

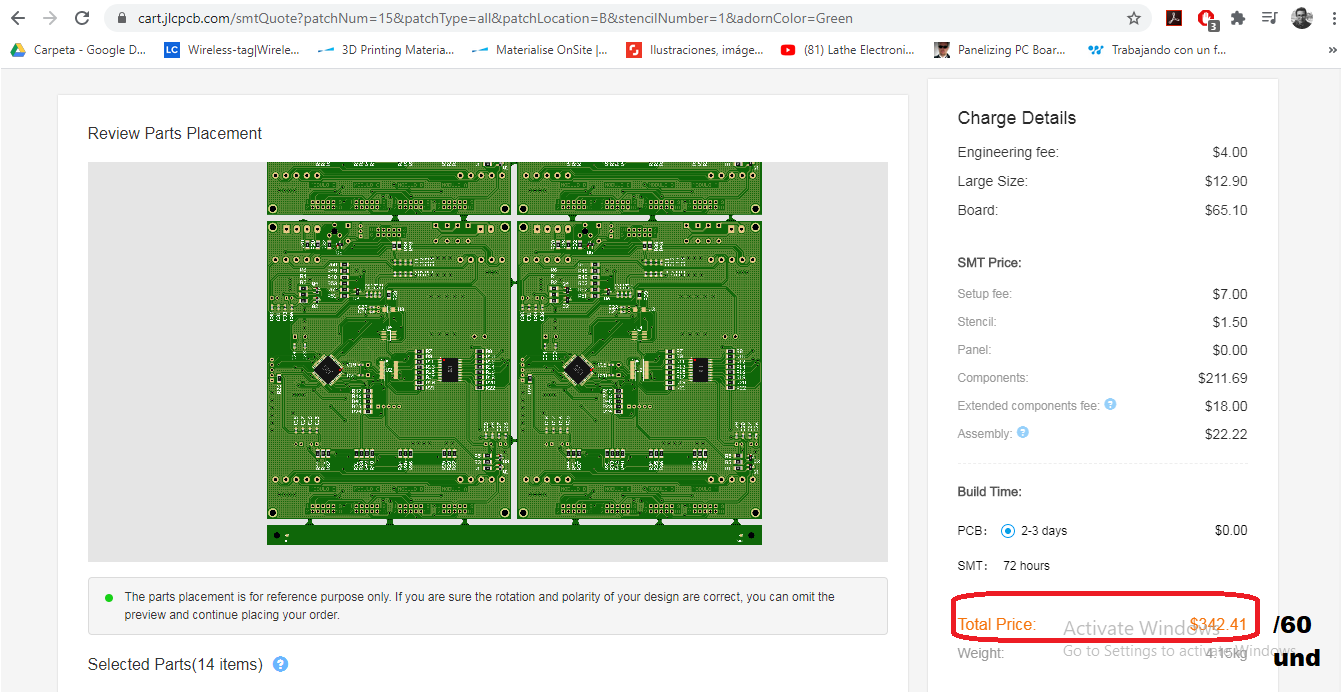
Hardware/000_Documentacion/Imagenes_Multimedia/08_PCB(Printed-Circuit-Board)+SMT(Surface-Mount Technology)DYSPLAYS.png
