EmbeddedSystemClass/patalla_pedidos_domicilo_TIA/Hardware/000_Documentacion/Imagenes_Multimedia/PCB_Fabrication_Services.png

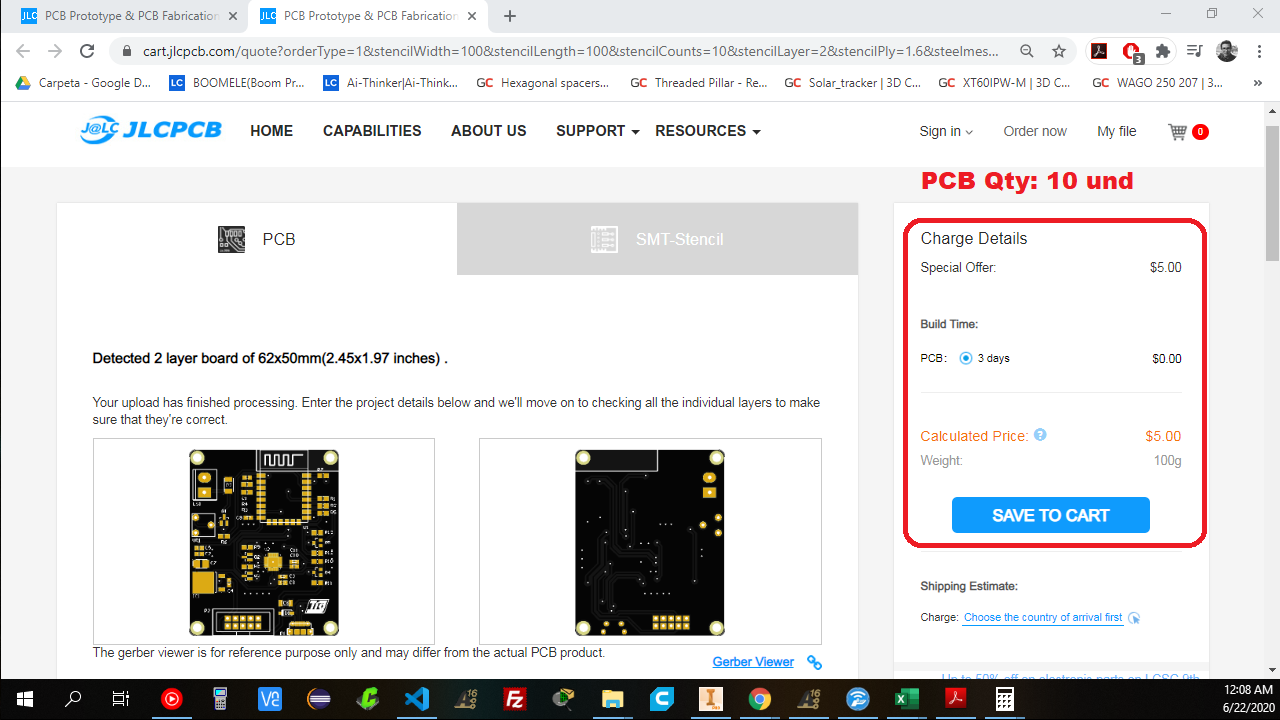
Hardware/000_Documentacion/Imagenes_Multimedia/PCB_Fabrication_Services.png
