EmbeddedSystemClass/patalla_pedidos_domicilo_TIA/Hardware/002_Fabricacion_Electronica/Guia_de_Panelizado/Fabrication Step_3.png

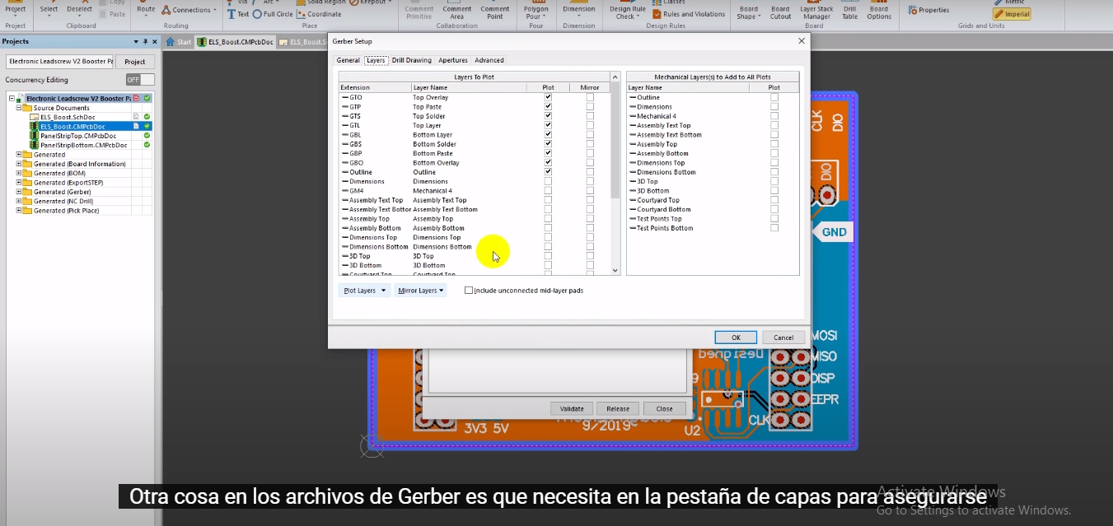
Hardware/002_Fabricacion_Electronica/Guia_de_Panelizado/Fabrication Step_3.png
