EmbeddedSystemClass/patalla_pedidos_domicilo_TIA/Hardware/002_Fabricacion_Electronica/Panel_PCB/Gerber_Panel_DISPLAYMASTER/Panel_DISPLAYMASTER_Combined_Top.png

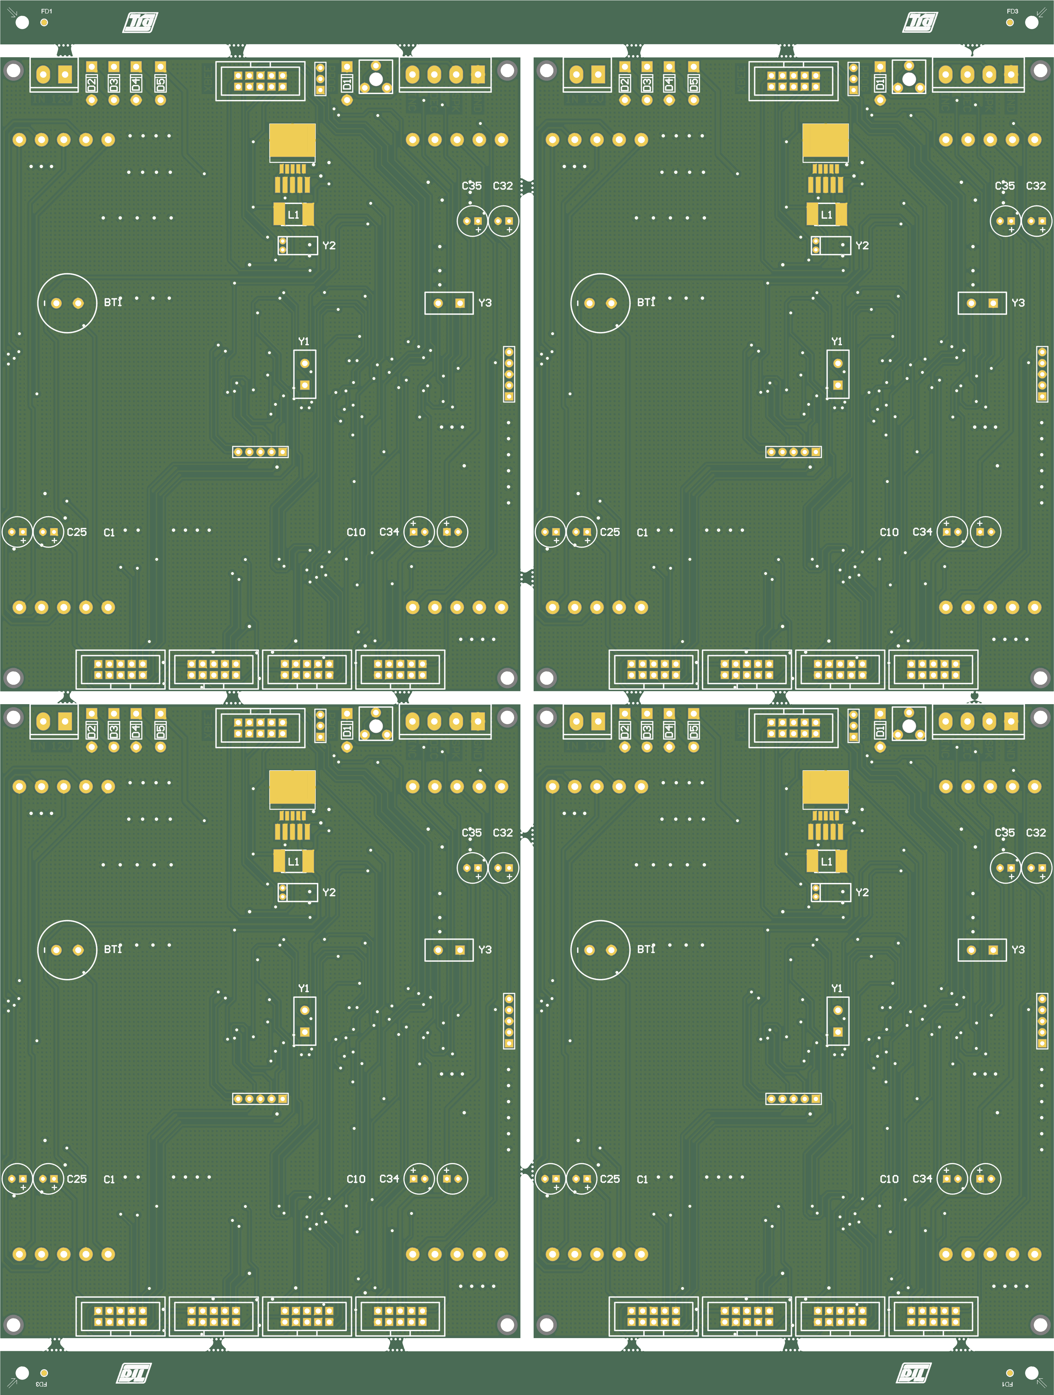
Hardware/002_Fabricacion_Electronica/Panel_PCB/Gerber_Panel_DISPLAYMASTER/Panel_DISPLAYMASTER_Combined_Top.png
