EmbeddedSystemClass/patalla_pedidos_domicilo_TIA/(list of files, drawings)

Other design files:
Hardware/001_Diseño_Electronico/BOARD.PcbDoc
Hardware/001_Diseño_Electronico/Breakouts.PcbLib
Hardware/001_Diseño_Electronico/CP2102.SchDoc
Hardware/001_Diseño_Electronico/Edge_Board.PcbDoc
Hardware/001_Diseño_Electronico/Edge_PLDISPLAYMASTER.PcbDoc
Hardware/001_Diseño_Electronico/ESP8266_Core.SchDoc
Hardware/001_Diseño_Electronico/Level_Shifter.SchDoc
Hardware/001_Diseño_Electronico/Lib_Altium/CP2102-GM_Lib/CP2102-GM.PCBLIB
Hardware/001_Diseño_Electronico/Lib_Altium/CP2102-GM_Lib/CP2102-GM.SCHLIB
Hardware/001_Diseño_Electronico/Lib_Altium/ESP-12E&F_Lib/ESP-12E&F Module.PcbLib
Hardware/001_Diseño_Electronico/Lib_Altium/ESP-12E&F_Lib/ESP-12E&F Module.SchLib
Hardware/001_Diseño_Electronico/main_sheet.SchDoc
Hardware/001_Diseño_Electronico/Order_Alert_Counter.PcbDoc
Hardware/001_Diseño_Electronico/Order_Alert_Display_Counter.PrjPcb
