EmbeddedSystemClass/patalla_pedidos_domicilo_TIA/Software/001_Codigo/firmware/Pantalla/display_alert_counter/Display_Wireless_Master/lib_rf2gh4_10.h

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

//********************
//*   DEFINICIONES   *
//********************

// PORTB                           
#define RF_IRQ     PIN_B0
#define RF_CS      PIN_A0
                          
// PORTC
#define   RF_CE    PIN_A2     
#define   SCK      PIN_C3
#define   SDI      PIN_C4
#define   SDO      PIN_C5

// PORTB
#define   RF_IRQ_TRIS   TRISB,0
#define   RF_CS_TRIS    TRISA,0

// PORTC
#define   RF_CE_TRIS    TRISA,2
#define   SCK_TRIS      TRISC,3
#define   SDI_TRIS      TRISC,4
#define   SDO_TRIS      TRISC,5



//*****************
//*   VARIABLES   *
//*****************                  
#BYTE TRISA     =  0xF92
#BYTE TRISB     =  0xF93      
#BYTE TRISC     =  0xF94
#BYTE TRISD     =  0xF95  
#BYTE INTCON    =  0xFF2

//Variables internas
static int1        interRF;
static int16       noRF;
static int1        RCVNW=0;
static int8        DATA_N_SND=0;
static int8        DATA_N_RCV=0;

//Variables configurables
static int8        RF_DATA[8];
static int8        RF_DIR;


//**************
//*   CÓDIGO   *
//**************

//*****************************************************
//*               RF_CONFIG_SPI()                     *
//*****************************************************
//*Descripción: La función configura el módulo SPI del*
//*microcontrolador.En ella se especifica como salida *
//*SDO y como entrada SDI entre otros parámetros del  *
//*protocolo SPI.                                     *
//*****************************************************
//*Variables de entrada:                              *
//*Variables de salida:                               *
//*****************************************************
void RF_CONFIG_SPI()                                                      
{    
   //Configuración I/O.         
   bit_clear(SCK_TRIS);
   bit_set(SDI_TRIS);  
   bit_clear(SDO_TRIS);

   //Configuración módulo comunicaciones.
   setup_spi(SPI_MASTER|SPI_L_TO_H|SPI_XMIT_L_TO_H
   |SPI_CLK_DIV_4|SPI_SAMPLE_AT_END);
} 
//*****************************************************


                         


//*****************************************************
//*                    RF_INT_EN()                    *
//*****************************************************
//*Descripción:Se encarga de habilitar la interrupción*
//*externa (RB0) utilizada por el módulo de RF en la  *
//*recepción de datos.                                *
//*****************************************************
//*Variables de entrada:                              *
//*Variables de salida:                               *
//*****************************************************
void RF_INT_EN()
{
   //Habilitar interrupciones externas con flanco de
   //bajada.
   disable_interrupts(global);
   enable_interrupts(int_ext);
   ext_int_edge( H_TO_L );
   bit_set(RF_IRQ_TRIS);
   enable_interrupts(global);
}
//*****************************************************





//*****************************************************
//*        RF_CONFIG(int canal, int dir)              *
//*****************************************************
//*Descripción:Esta función se encarga de configurar  *
//*el transceptor habilitando su propia dirección de  *
//*escucha y el canal entre otros parámetros.         *
//*****************************************************
//*Variables de entrada:- Canal                       *
//*                     - Direccion                   *
//*Variables de salida:                               *
//*****************************************************
void RF_CONFIG(int canal, int dir)
{

   bit_clear(RF_CS_TRIS);
   bit_set(RF_IRQ_TRIS);
   bit_clear(RF_CE_TRIS);

   output_low(RF_CE);

   // TX_ADDR (0xFF)
   //Configuración de la dirección de envio aleatoria.
   //En la función de enviar se configura la direccion
   //deseada por el usuario.
   output_low(RF_CS);
   spi_write(0x30);
   spi_write(0xFF);
   spi_write(0xC2);
   spi_write(0xC2);
   spi_write(0xC2);
   spi_write(0xC2);
   output_high(RF_CS);

   // RX_ADDR_P0 (0xFF) ACK
   //Configuración de la direccióndel Pipe0 para la
   //recepción de ACK.
   output_low(RF_CS);
   spi_write(0x2A);                                              
   spi_write(dir);
   spi_write(0xC2);                 
   spi_write(0xC2);
   spi_write(0xC2);                    
   spi_write(0xC2);
   output_high(RF_CS);

   // RX_ADDR_P1 (dir)
   //Configuración de la direccióndel Pipe1 para la
   //recepción de tramas.
   output_low(RF_CS);
   spi_write(0x2B);
   spi_write(dir);
   spi_write(0xC2);
   spi_write(0xC2);
   spi_write(0xC2);
   spi_write(0xC2);
   output_high(RF_CS);

   // RX_ADDR_P2 (0x00) BROADCAST
   //Configuración de la direccióndel Pipe2 para la
   //recepción de tramas
   output_low(RF_CS);
   spi_write(0x2C);
   spi_write(0x00);
   output_high(RF_CS);

   // EN_AA
   //Habilitar AutoAck en los Pipe0,Pipe1 y Pipe2.
   output_low(RF_CS);
   spi_write(0x21);
   spi_write(0x07);
   output_high(RF_CS);

   // EN_RXADDR
   //Habilitar los Pipe0,Pipe1 y Pipe2.
   output_low(RF_CS);                                 
   spi_write(0x22);                                       
   spi_write(0x07);
   output_high(RF_CS);

   // SETUP_AW
   //Configuración de la longitud de las direcciones.
   //Direcciones de 5 bytes.
   output_low(RF_CS);
   spi_write(0x23);
   spi_write(0x03);
   output_high(RF_CS);

   //SETUP_RETR
   //Configuración de las retrasmisiones en la transmisión.
   //Diez retransmisiones cada 336us.
   output_low(RF_CS);
   spi_write(0x24);
   spi_write(0x0A);
   output_high(RF_CS);

   //RF_CH
   //Configuración del canal.
   //Canal elegido por el usuario (0x01 - 0x7F).
   output_low(RF_CS);
   spi_write(0x25);
   spi_write(canal);
   output_high(RF_CS);

   //RF_SETUP
   //Configuración aspectos RF.
   //Ganancia máxima de LNA, 0dBm potencia de salida y 2Mbps de velocidad.
   output_low(RF_CS);
   spi_write(0x26);       
   spi_write(0x27);
   output_high(RF_CS);

   //STATUS
   //Reseteo del registro STATUS                                 
   output_low(RF_CS);
   spi_write(0x27);
   spi_write(0x70);
   output_high(RF_CS);

   //RX_PW_P0
   //Nº de bytes en Pipe0.
   //1 byte (ACK).
   output_low(RF_CS);
   spi_write(0x31);
   spi_write(0x01);
   output_high(RF_CS);

   //RX_PW_P1
   //Nº de bytes en Pipe1.
   //10 byte (Direccion emisor y trama).
   output_low(RF_CS);
   spi_write(0x32);
   spi_write(0x0A);
   output_high(RF_CS);

   //RX_PW_P2
   //Nº de bytes en Pipe2.
   //10 byte (Direccion emisor y trama).
   output_low(RF_CS);
   spi_write(0x33);
   spi_write(0x0A);
   output_high(RF_CS);
}
//*****************************************************








//*****************************************************
//*                    RF_ON()                         *
//*****************************************************
//*Descripción:Esta rutina activa el módulo de        *
//*radiofrecuencia en modo escucha para poder recibir *
//*datos enviados a su dirección.                     *
//*****************************************************
//*Variables de entrada:                              *
//*Variables de salida:                               *
//*****************************************************
void RF_ON()
{

   output_low(RF_CE);

   // CONFIG
   //Se activa el modulo, se pone en recepción,
   //se activa el CRC para que utilice 2 bytes.
   output_low(RF_CS);
   spi_write(0x20);
   spi_write(0x0F);
   output_high(RF_CS);

   delay_ms(2);
   output_high(RF_CE);
   delay_us(150);
}
//*****************************************************









//*****************************************************
//*                 RF_OFF()                         *
//*****************************************************
//*Descripción:Este procedimiento desactiva el módulo *
//*de radiofrecuencia.                                *
//*****************************************************
//*Variables de entrada:                              *
//*Variables de salida:                               *
//*****************************************************
void RF_OFF()
{
   output_low(RF_CE);

   // CONFIG
   //Se desactiva el modulo
   output_low(RF_CS);
   spi_write(0x20);
   spi_write(0x0C);
   output_high(RF_CS);
}
//*****************************************************








//*****************************************************
//*                 RF_SEND()                         *
//*****************************************************
//*Descripción:Esta función envía 8 Bytes de datos a  *
//*la dirección indicada informando de la correcta    *
//*recepción en el destinatario.                      *
//*****************************************************
//*Variables de entrada:- RF_DATA[]                   *
//*                     - RF_DIR
//*Variables de salida: -                             *
//*Salida:              - 0: Envío correcto (ACK OK)  *
//*                     - 1: No recepcibido (NO ACK)  *
//*                     - 2: No enviado               *
//*****************************************************
int RF_SEND()
{
   int i;
   int estado;


   if(bit_test(INTCON,7))
      interRF=1;
   else
      interRF=0;

   disable_interrupts(GLOBAL);

   // INICIO
   output_low(RF_CE);

   //STATUS
   //Reseteo del registro STATUS
   output_low(RF_CS);
   spi_write(0x27);
   spi_write(0x70);
   output_high(RF_CS);

   // EN_RXADDR
   //Se habilita el Pipe0 para la recepción del ACK
   output_low(RF_CS);
   spi_write(0x22);
   spi_write(0x01);
   output_high(RF_CS);

   // TX_ADDR
   //Se configura la dirección de transmisión=RF_DIR
   output_low(RF_CS);
   spi_write(0x30);
   spi_write(RF_DIR);
   spi_write(0xC2);
   spi_write(0xC2);
   spi_write(0xC2);
   spi_write(0xC2);
   output_high(RF_CS);

   // RX_ADDR_P0
   //Para la recepción del ACK se debe configurar el Pipe0 con
   //la misma dirección a trasmitir.
   output_low(RF_CS);
   spi_write(0x2A);
   spi_write(RF_DIR);
   spi_write(0xC2);
   spi_write(0xC2);
   spi_write(0xC2);
   spi_write(0xC2);
   output_high(RF_CS);

   // RX_ADDR_P1
   //Se mete en RF_DIR la direccion propia.
   //De esta manera el receptor sabe la dirección
   //del transmisor.
   output_low(RF_CS);
   spi_write(0x0B);
   RF_DIR=spi_read(0);
   spi_read(0);
   spi_read(0);
   spi_read(0);
   spi_read(0);
   output_high(RF_CS);

   // W_TX_PAYLOAD
   //Se manda los datos al transductor
   output_low(RF_CS);
   spi_write(0xA0);

   DATA_N_SND++;
   spi_write(DATA_N_SND);
   spi_write(RF_DIR);
   for (i=0;i<8;i++)
      spi_write(RF_DATA[i]);

   output_high(RF_CS);

   // CONFIG
   //Se pasa a modo transmisión.
   output_low(RF_CS);
   spi_write(0x20);
   spi_write(0x0E);
   output_high(RF_CS);

   // Pulso de comienzo de envío
   output_high(RF_CE);
   delay_us(15);
   output_low(RF_CE);

   noRF=0;

   while (input(RF_IRQ)==1) {
      noRF++;
      //Si no da respuesta en 7ms, no se ha enviado.
      if(noRF==500){
      break;
         }
   }


   // STATUS
   //Lectura del estado en el registro estatus.
   output_low(RF_CS);
   estado=spi_read(0x27);
   spi_write(0x70);
   output_high(RF_CS);


   // EN_RXADDR
   //Habilitar los Pipe0,Pipe1 y Pipe2.
   output_low(RF_CS);
   spi_write(0x22);
   spi_write(0x07);
   output_high(RF_CS);

      // TX_FLUSH
   //Limpieza de la FIFO de salida
   output_low(RF_CS);
   spi_write(0xE1);
   output_high(RF_CS);

   // CONFIG
   //Paso a modo recepción
   output_low(RF_CS);
   spi_write(0x20);
   spi_write(0x0F);
   output_high(RF_CS);

   // FIN
   output_high(RF_CE);

   delay_us(150);

   //Si no da respuesta en 7ms, no se ha enviado.
   if(noRF==500){
        if(interRF==1)
        enable_interrupts(GLOBAL);
        clear_interrupt(int_ext);
        return(2);
   }

   //estado
   //Chequeo de los bit del registro STATUS que indican si se ha recibido
   //ACK y si se ha terminado las retrasmisiones sin ningun ACK.
   if ((bit_test(estado,4)==0) && (bit_test(estado,5)==1)){
      if(interRF==1)
      enable_interrupts(GLOBAL);
      clear_interrupt(int_ext);
      return(0);
      }
   else{
      if(interRF==1)
      enable_interrupts(GLOBAL);
      clear_interrupt(int_ext);
      return(1);
      }
}
//*****************************************************









//*****************************************************
//*                 RF_RECEIVE()                      *
//*****************************************************
//*Descripción: Esta rutina se encarga de comprobar si*
//*se ha producido una recepción y de ser así,        *
//*devuelve la trama recibida.                        *
//*****************************************************
//*Variables de entrada:-                             *
//*Variables de salida: - RF_DATA[]                   *
//*                     - RF_DIR                      *
//*Salida:         - 0: Recepción correcta y única    *
//*                - 1: Recepción correcta y múltiple *
//*                - 2: No se ha producido recepción  *
//*                - 3: No se ha producido recepción  *
//*****************************************************
int RF_RECEIVE()
{

   int i;
   int mas;
   int estado;

   if (input(RF_IRQ)==1 && RCVNW==0){
      return (2);
      }

   //STATUS
   //Lectura y reseteo del registro STATUS
   output_low(RF_CS);
   estado=spi_read(0x27);
   spi_write(0x70);
   output_high(RF_CS);

   //estado
   //Chequeo de la interrupción de recepción.
   if (bit_test(estado,6)==0 && RCVNW==0){
      return(3);
      }

   //R_RX_PAYLOAD
   //Lectura de los datos recibidos.
   output_low(RF_CS);
   spi_write(0x61);
   DATA_N_RCV=spi_read(0);
   RF_DIR=spi_read(0);
   for (i=0;i<8;i++)
   {
      RF_DATA[i]=spi_read(0);
   }
   output_high(RF_CS);

   //FIFO_STATUS
   //Comprobación del estado de la FIFO de
   //recepción para comprobar si hay más datos
   output_low(RF_CS);
   spi_write(0x17);
   mas=spi_read(0);
   output_high(RF_CS);

   if (bit_test(mas,0)==0){
      RCVNW=1;
      return(1);
   }
      RCVNW=0;
      return(0);
}
//*****************************************************
