EmbeddedSystemClass/patalla_pedidos_domicilo_TIA/Software/001_Codigo/firmware/Pantalla/display_alert_counter/Display_Wireless_Master/main_master.h

#include <18F4520.h>
#device ADC=16

#FUSES NOWDT                    //No Watch Dog Timer
#FUSES NOBROWNOUT               //No brownout reset
#FUSES NOLVP                    //No low voltage prgming, B3(PIC16) or B5(PIC18) used for I/O
#FUSES NOXINST                  //Extended set extension and Indexed Addressing mode disabled (Legacy mode)

#use delay(internal=8000000)
