EmbeddedSystemClass/patalla_pedidos_domicilo_TIA/(commit log)

2020-12-29 Cambio en la estructura del repositorio
    [28mm 8Ohm 1W Full Range Audio Speaker.STEP, 28mm 8Ohm 1W Full Range Audio Speaker.ipt, 6436355536.iam, 73k0102_1658621-1.ipt, 73k0102_1658621-1.stp, 931411456.iam, 931418936.iam, 931419072.iam]
2020-12-29 Documentacion en el Firmware
2020-12-29 Cambio de directorio del Firmware
2020-12-29 Cambio en los directorios de Hardware
    [Back.dwg, Case_Pedidos Counter.xlsx, Front.dwg, Separadores_PCB.0003.ipt, Separadores_PCB.ipt, Separadores_PCB10mm.stl, Separadores_PCB17mm.stl, SupportLevel.ipt]
