EmbeddedSystemClass/patalla_pedidos_domicilo_TIA/(notices)

Notices in the files:
Software/001_Codigo/firmware/Pantalla/display_alert_counter/Display_Wireless_Master/lib_rf2gh4_10.h:
Copyright (C) 2007 Bizintek Innova S.L.
This program is free software; you can redistribute it and/or modify
it under the terms of the GNU General Public License as published by
the Free Software Foundation; either version 2 of the License, or
(at your option) any later version.
